ericjhoh/6-DOF-Arm/blog_documentation.docx

# Blog Documentation

## 8/20/2026

Due to all the backlash from the first version of the 30:1 Cycloidal Gearbox, I decided that there were likely 2 things to change that could reduce the given backlash.

1. 3D-print the cycloidal disks slightly larger than before.
2. Reprint the input wall so that the holes holding the roller pins were press-fit instead of loose fit.

I believed that the loose fit of the previous input wall roller pin holes allowed the pins to move slightly when the cycloidal disk applied pressure to the bearings. This means that when switching directions the cycloidal disk would have some give before the disk and the rollers latch back together.

## 8/21/2026

This day was spent printing most of the parts and testing whether they would fit. I found that printing the disk with an offset of .1 mm to increase the size worked the best with my 3d printer. The input wall holes for the roller should be the nominal 5 mm diameter.

## 8/22/2026

After assembly, I observed much less backlash than before and I will be testing the efficiency of the gearbox and compare it to version 1 of the 30:1 cycloidal gearbox. I will also be printing the 15:1 gearbox in the following days after adding identifiers in the CAD to make assembly easier.

## 8/23/2026

I spent this day printing most of the parts. I ran into some issues with the fitting of the shoulder bolts that secure the outer walls of the print, it was very tight for the 15:1.

## 8/24/2026

After assembling the entirety of the 15:1 gearbox, I noticed that the input shaft felt difficult to turn as if it were experiencing a lot of friction. From my observations it seemed like one of the input camshaft part was rubbing against the output flange making more friction.

## 8/25/2026

I didn’t get to work that much on the project this day, but I disassembled the 15:1

## 8/26/2026

After making some edits to the CAD, I am reprinting many parts so that they fit better together.
