ericjhoh/6-DOF-Arm/6-DOF-Arm_Documentation (1).docx

# 6-DOF-Arm Documentation

By Eric Oh

8/13/2026

# Introduction:

The goal of this project is to fully develop a 6 degrees of freedom robotic arm that can accomplish a pick and place task. Possible integration with a future drone to support a landing pad.

# Requirements:

## Functional

- Six independently actuated rotational degrees of freedom.
- Complete a pick-and-place task: approach, grasp, transport, and release a target object.
- Design payload of 0.4 kg at the tool center point (TCP).
- 400 mm reach measured from the base yaw axis to the TCP.
- Capture teleoperated demonstrations and reproduce the task autonomously through imitation learning.
- Stretch goal: serve as a landing-pad manipulator for a future drone platform.

## Mechanical

- Every joint must hold at least a 1.2x torque margin over its worst-case static holding torque.
- Structure must be manufacturable with the fabrication capability actually on hand: a consumer FDM 3D printer, set screws, and heat-set inserts. No epoxy, no machined inserts, no outsourced machining.
- Link mass budget of 0.06 kg per link (carbon fiber tube plus printed clamps).
- Joint gearboxes must couple to one another without introducing an axial offset that creates a large parasitic moment.

## Electrical

- All six actuators share a common power rail and a single CAN-FD bus in a daisy-chain topology.
- Absolute rotary position feedback at every joint.
- Controller mounting must not interfere with motor body geometry or rotor magnet standoff.

## Software

- Run on the LeRobot stack for demonstration recording, policy training, and inference.
- Per-joint commissioning through the moteus tooling (calibration, position/velocity/torque control modes).

# System Architecture:

The arm is built around Architecture v2, which replaced the original stepper-driven concept with quasi-direct-drive brushless actuators. The joint order and link lengths are as follows:

Joint | Function | Notes
J1 | Base yaw | Rotates the entire arm about the vertical axis
J2 | Shoulder pitch | Highest-torque joint; drives L1
J3 | Elbow pitch | Drives L2
J4 | Forearm roll | Located at the elbow, not at the wrist
J5 | Wrist pitch | Wrist assembly
J6 | Tool roll | End effector rotation

Link geometry: L1 = L2 = 160 mm, giving a 400 mm total reach with the wrist and tool stack included. Placing J4 at the elbow rather than the wrist keeps the roll actuator mass closer to the shoulder, which reduces the inertia and holding torque that J2 and J3 have to carry.

# Actuation:

The arm uses two actuator families. The three proximal joints, which carry the bulk of the load, use MJ5208 brushless motors driven by moteus r4.11 controllers through custom cycloidal reducers. The three distal wrist joints use SteadyWin GIM3505-8 integrated gearmotors driven by moteus-c1 controllers.

Joint | Motor | Controller | Reduction | Reducer type
J1 | MJ5208 | moteus r4.11 | 15:1 | Custom cycloidal
J2 | MJ5208 | moteus r4.11 | 30:1 | Custom cycloidal
J3 | MJ5208 | moteus r4.11 | 15:1 | Custom cycloidal
J4 | GIM3505-8 | moteus-c1 | 8:1 | Integrated planetary
J5 | GIM3505-8 | moteus-c1 | 8:1 | Integrated planetary
J6 | GIM3505-8 | moteus-c1 | 8:1 | Integrated planetary

## MJ5208 (J1-J3)

The MJ5208 is a 5208-frame brushless motor sold by mjbots, wound at 330 Kv and intended specifically for pairing with moteus controllers. It is a bare motor, so there are no gearbox and no encoder, which is why J1-J3 need the custom cycloidal reducers and a separately mounted diametric magnet.

Parameter | Value
Frame size | 5208
Peak torque | 1.7 N.m
Peak power | 600 W
Kv | 330 rpm/V
Maximum speed | 7500 RPM

### Derived torque constant

From Kv = 330 rpm/V, the torque constant is approximately 9.55 / 330 = 0.029 N.m/A at the rotor. Producing the rated 1.7 N.m peak therefore requires roughly 59 A of phase current. Kv conventions vary between manufacturers by 10-15 percent depending on how the winding is referenced, so treat this as an estimate until calibration returns a measured value.

### Peak versus continuous output - important

The 1.7 N.m headline figure is a transient peak, not a torque the joint can hold. The moteus r4.11 is rated at 100 A peak phase current but only 12 A continuous uncooled (32 A with thermal management), and the shoulder holding a pose is a continuous demand, not a transient one. Working the numbers through both reduction ratios:

Operating point | Phase current | Motor torque | J2 output (30:1) | J1/J3 output (15:1)
Peak (transient only) | ~59 A | 1.7 N.m | 51 N.m | 25.5 N.m
Continuous, cooled | 32 A | 0.93 N.m | 27.7 N.m | 13.9 N.m
Continuous, uncooled | 12 A | 0.35 N.m | 10.4 N.m | 5.2 N.m

All of these are before cycloidal efficiency losses, 3D-printed part compliance, and any thermal derating of the motor itself, so real sustained output is lower still.

The practical consequence is that the honest number for the J2 static holding case is 10.4 N.m, not 51 N.m - roughly a factor of five smaller. If the torque budget was built against the peak figure, that alone could explain why the shoulder margin looks marginal. Adding a heat spreader or fan to the J1-J3 controllers moves the continuous ceiling from 12 A to 32 A and is the cheapest available lever on this problem.

## GIM3505-8 (J4-J6)

The GIM3505-8 is an integrated 8:1 planetary gearmotor with an onboard 14-bit magnetic encoder. Because the wrist joints see far lower torque than the shoulder and elbow, an off-the-shelf integrated unit is used here rather than a custom reducer, which saves both design time and distal mass.

Manufacturer specifications (from the GDZ-driver planetary reduction motor selection table):

Parameter | Value
Gear ratio | 8:1
Gearbox type | Planetary, aluminum gears
Rated torque (output) | 0.67 N.m
Peak torque (output) | 1.79 N.m
Rated speed (output) | 230 RPM
Maximum speed (output) | 400 RPM
Rated voltage | 24 V
Operating voltage range | 12-40 V
Rated power | 36.72 W
Rated current | 1.53 A
Peak current | 3.99 A
Torque constant | 0.44 N.m/A (output-referenced)
Speed constant | 16.67 rpm/V (output-referenced)
Phase resistance | 5.473 ohm
Phase inductance | 0.476 mH
Gear backlash | 15 arcmin

### Torque headroom at the wrist

The 0.67 N.m continuous rating is generous for this application. A 0.2 kg payload weighs 1.96 N, so it demands roughly 0.20 N.m at J5 for every 100 mm of offset between the J5 axis and the payload center of mass. J5 therefore stays inside its continuous rating out to about 340 mm of offset - far beyond anything the wrist geometry will produce. The wrist joints are not the constraint on this arm; the shoulder is.

### Driver substitution: moteus-c1 in place of the GDZ34

The GIM3505-8 normally ships with a GDZ34 integrated driver. This design discards it in favor of the moteus-c1, so that all six joints run the same firmware, the same CAN-FD bus, and the same torque-control interface. That substitution means the motor has to be characterized at the rotor rather than at the output, since the moteus-c1 commutates the rotor directly:

- Pole pairs: 11 - used directly in the moteus configuration.
- Phase resistance 5.473 ohm, phase inductance 0.476 mH - these set the current-loop bandwidth and gains during calibration.
- Rotor-referenced torque constant: ~0.055 N.m/A (0.44 divided by the 8:1 ratio). The catalog value is measured at the gearbox output, so using 0.44 directly in a rotor-side configuration would overestimate torque by 8x.
- Rotor-referenced speed constant: ~133 rpm/V (16.67 multiplied by 8), for the same reason.

The stock GDZ34 speaks CAN and RS-485; the moteus-c1 speaks CAN-FD. Since the GDZ34 is being removed anyway, this protocol difference does not need to be bridged.

### Integration between GIM3505-8 and moteus-c1

Integrating the GIM3505-8 motor with the moteus-c1 can be done by ordering the GIM3505-8 with an AS5047P encoder. This is the same encoder that is on the moteus-c1 controller. In order to connect the external AS5047P encoder with the moteus-c1, AUX2 must be used on the controller. INSERT DOCUMENTATION

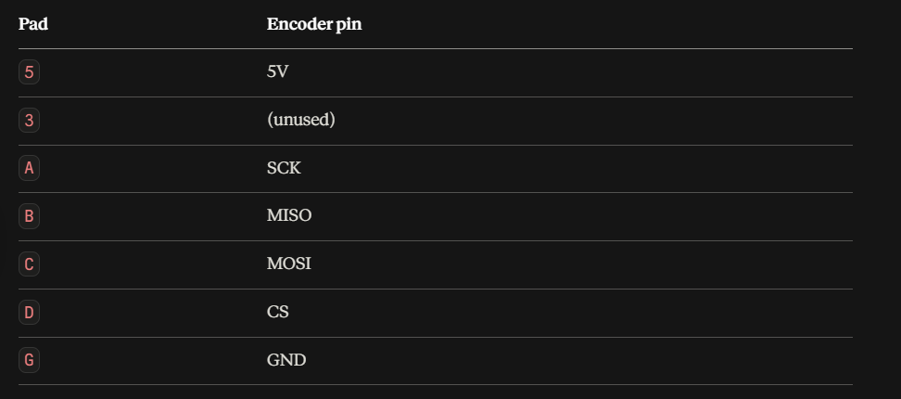
[picture p1: figure]

And the 3 phases can be connected to the 3 phases of the motor. In addition, some configurations must be set through the moteus-c1

conf set aux1.spi.mode 1

conf set aux2.pins.0.mode 1

conf set aux2.pins.1.mode 1

conf set aux2.pins.2.mode 1

conf set aux2.pins.3.mode 2

conf set aux2.spi.mode 2

conf set aux2.spi.rate_hz 12000000

conf set motor_position.sources.0.aux_number 2

conf set motor_position.sources.0.type 1

conf set motor_position.sources.0.cpr 16384

conf set motor_position.sources.0.reference 0

conf set motor_position.commutation_source 0

conf set motor_position.output.source 0

conf set motor_position.rotor_to_output_ratio 0.125

conf write

Three blocks: get the old sensor out of the way, describe the physical hardware, then say what the readings mean.

Freeing the onboard encoder

aux1.spi.mode 1 — sets AUX1's SPI to Disabled. The default is 0, meaning the onboard AS5047P. Without this the firmware keeps polling a chip with no magnet in front of it and reports faults. This is the line that makes the whole plan work, since the c1 has no way to physically remove that sensor.

Describing the hardware on AUX2

aux2.pins.0/1/2.mode 1 — pins A, B, C become the SPI bus (clock, MISO, MOSI, in that fixed order). Three separate lines because each pin is configured independently; the firmware doesn't infer that enabling one implies the others.

aux2.pins.3.mode 2 — pin D becomes chip select, for the reason from the last message: it's a GPIO the firmware toggles, not part of the shared bus.

aux2.spi.mode 2 — declares that an AS5047-family part is on that bus. This selects the register-level protocol: which address to read, how the 14-bit angle is packed, what the parity bit means. The pin modes above build the road; this says what's at the end of it.

aux2.spi.rate_hz 12000000 — bus clock. This is the one line you can drop — it's already the default. I included it as a marker for the value you'll be turning down if error counts appear once the motor is driving.

Saying what the reading means

The first four lines configure "source 0," one of several sensor slots the firmware can track.

sources.0.aux_number 2 — this source lives on AUX2. Necessary because sources and ports are decoupled; nothing so far has connected the two.

sources.0.type 1 — read it as SPI, rather than quadrature or I2C.

sources.0.cpr 16384 — counts per revolution. The AS5047P is 14-bit, so 2^14. This is how raw counts become an angle; wrong here and everything downstream scales wrong.

sources.0.reference 0 — this sensor measures the rotor, not the output. True for your setup: the encoder sits behind the motor, ahead of the planetary. This is a claim about mechanical reality, and the one line most likely to be wrong if you ever move an encoder to the output side.

Wiring the source into the control loop

The 0 in the next two lines is a source index, not an enum value — it means "source 0," the thing just defined.

motor_position.commutation_source 0 — use it to time the phase currents. Requires a rotor-referenced source, which is why reference 0 above matters.

motor_position.output.source 0 — also use it to report position. On a joint with only one sensor, both jobs fall to the same source. They're separate fields because a two-encoder joint would split them.

rotor_to_output_ratio 0.125 — output turns per rotor turn, i.e. your 8:1. Without it, positions and velocities come back in rotor revolutions and every command you write is off by 8×.

conf write — commits to flash. Everything above is RAM-only until this runs.

The short version of why nothing is redundant: the pin lines describe electrical routing, spi.mode describes the protocol, the source lines describe what the number physically represents, and the last three describe what the control loop should do with it. Each layer is independent, so each needs stating.

# Cycloidal Reducer Design:

Two reducer designs were developed: a 30:1 unit for the shoulder and a 15:1 unit built in two copies for the base yaw and elbow. Both share the same architectural pattern - twin cycloidal discs mounted 180 degrees out of phase to cancel the eccentric imbalance, a hex input shaft, ring rollers on pins, and an output roller pin circle.

## 30:1 Reducer (J2 - Shoulder)

Parameter | Value
Reduction ratio | 30:1
Ring diameter | 120 mm
Ring rollers | 31 rollers, 10 mm diameter (5 mm radius)
Camshaft diameter | 20 mm
Output pin circle | 80 mm
Output rollers | 8 rollers, 10 mm diameter
Cycloidal discs | 2 discs, 8 mm thick, 180 degrees apart
Eccentricity | 1.0 mm
Profile coefficient K1 | 0.52
Input | Hex shaft
Disc material | PLA or PETG (selection pending)
Assembly mass | ~1.32 kg including motor and controller

The cam assembly requires two eccentric bearings (one per disc) plus two support bearings in line with the input axis, so the eccentric loads are reacted on both sides rather than cantilevered. INSERT DOCUMENTATION OF TESTING AND RESULTS AND DESIGN ITERATION

Status note: at 120 mm ring diameter and 1.32 kg assembled, this unit is judged too large for the shoulder. Shrinking the envelope is an active work item; the constraint is that any reduction in ring diameter reduces the moment arm at the output rollers and therefore the torque capacity, so the shrink cannot be a straight scale-down.

## 15:1 Reducer (J1 - Base Yaw, J3 - Elbow)

Two identical units are being built from a common template.

Parameter | Value
Reduction ratio | 15:1
Ring rollers | 16 rollers, 10 mm diameter (5 mm radius)
Camshaft diameter | 10 mm
Output rollers | 6 rollers, 10 mm diameter
Cycloidal discs | 2 discs, 180 degrees apart
Disc center hole | ~20 mm
Output roller holes | ~12 mm
Input | 5 mm hex shaft
Cam | 3D printed

# Electronics and Control:

## Bus topology

All controllers sit on a shared power rail and a single CAN-FD daisy chain. Three moteus r4.11 controllers are currently in hand and are being wired into this chain for J1-J3; the three moteus-c1 controllers for the wrist join the same bus.

Parameter | moteus r4.11 (J1-J3) | moteus-c1 (J4-J6)
Voltage input | 10-44 V | 10-51 V
Peak phase current | 100 A | 20 A
Continuous phase current (uncooled) | 12 A | 5 A
Continuous phase current (cooled) | 32 A | 14 A
Peak electrical power | 900 W @ 30 V | 250 W @ 28 V
Mass | 14.2 g | 8.9 g
Dimensions | 46 x 53 mm | 38 x 38 x 9 mm
CPU | STM32G4 | STM32G4
Communications | 5 Mbps CAN-FD | 5 Mbps CAN-FD

Both boards run the same firmware image and use the same power, CAN, and AUX2 connectors, so the mixed r4.11 / c1 chain behaves as one homogeneous bus from the host's point of view.

Rail voltage is set at 24 V. The binding constraint is the GIM3505-8's 12-40 V operating window - narrower than either controller's input range - and 24 V is also the GIM3505-8's rated voltage. This sits comfortably inside the r4.11's 10-44 V and the c1's 10-51 V.

Current headroom check: the GIM3505-8 draws 1.53 A rated and 3.99 A peak, against the c1's 5 A continuous and 20 A peak. The wrist is comfortably matched. The MJ5208 side is the opposite case - the motor can absorb far more current than the r4.11 can continuously supply, so the controller, not the motor, sets the sustained torque ceiling at J1-J3.

## Position feedback

- J1-J3: moteus-style on-axis magnetic encoder, using a diametric magnet mounted on the stator-side axle. This is the standard moteus rotor-position arrangement and keeps the sensing on the motor side of the reducer.
- J4-J6: the plan is to wire the GIM3505-8's own motor-side AS5047P to the moteus-c1, rather than using the AS5047P that is already onboard the c1. This sidesteps the magnet standoff problem described below, since the motor's factory encoder is already correctly spaced from its own rotor magnet.

## Bring-up status

Currently at hardware bring-up: running moteus_tool --calibrate against an MJ5208 + moteus r4.11 pair on Windows under miniconda. Calibration establishes the commutation offset and encoder mapping, and has to be completed per motor-controller pair before any closed-loop position control.

# Software and Learning Stack:

The arm targets imitation learning as its control approach rather than classical trajectory planning. The intended pipeline is:

1. Record teleoperated demonstrations of the pick-and-place task.
2. Train a policy on those demonstrations using the LeRobot stack.
3. Run inference on the trained policy with the arm executing autonomously.

This choice drives several hardware requirements upstream: joints need smooth, backdrivable-feeling torque control for teleoperation, and the control loop needs consistent timing, which is why every joint runs a moteus controller with onboard closed-loop control rather than a step/direction driver.

# Design History:

## v1 - Stepper architecture (superseded)

The original design used NEMA 17 stepper motors with TMC2209 drivers. Two problems ended this approach:

- Torque margin. Steppers at this frame size could not deliver the holding torque required at the shoulder within the 1.2x margin, even before accounting for reducer losses.
- Driver current mismatch. The TMC2209 could not supply the 2.0 A/phase the selected motors required. The options were to upgrade to TMC5160 drivers or to drop to lower-current motors; the latter would have made the torque problem worse.

Rather than upgrade the drivers, the architecture moved to quasi-direct-drive brushless motors with moteus controllers, which solves the torque margin, the current capability, and the torque-control requirement for imitation learning in one change.

## v2 - Brushless architecture (current)

MJ5208 + moteus r4.11 with custom cycloidal reducers on J1-J3; GIM3505-8 + moteus-c1 on J4-J6. This is the architecture documented above.

# Open Issues:

## 1. J2 shoulder torque margin below threshold

The shoulder joint's torque margin currently sits below the 1.2x requirement in the torque budget. This is the single most important blocking item, since it determines whether the 30:1 reducer and MJ5208 combination is sufficient at all.

Check the basis of the number first. As set out in the Actuation section, the MJ5208's 1.7 N.m rating is a transient peak requiring roughly 59 A of phase current. Sustained holding torque at J2 is bounded by the moteus r4.11's continuous current rating, which puts the real figure near 10.4 N.m uncooled rather than 51 N.m. If the budget was populated from the peak number, the margin calculation needs redoing before any mechanical change is made in response to it.

Once the basis is confirmed, resolution paths include adding thermal management to the J2 controller (12 A to 32 A continuous, a 2.7x gain for the price of a heat spreader), reducing distal mass, shortening L1, increasing the reduction ratio, or revising the payload target.

## 2. Gearbox-to-gearbox coupling

There is no settled answer for how to connect adjacent joint gearboxes without introducing an axial offset between their output and input planes. Any offset creates a moment arm that loads the reducer output bearings in a direction they are not designed to carry, and the 3D-printed housings are the least tolerant part of the stack to that kind of loading.

## 3. moteus-c1 mounting on the GIM3505-8

- Magnet standoff: the c1 cannot sit close enough to the GIM3505-8's rotor magnet, because the motor's rear geometry interferes with components on the board. The current workaround is to use the motor's own AS5047P instead of the c1's onboard encoder.
- Screw holes: the c1's mounting holes land directly on the motor body. Fastening through them as-is would drive screws into the motor. A standoff or adapter plate is needed.

## 4. 30:1 reducer envelope

The 120 mm ring diameter and 1.32 kg assembly mass are both larger than the shoulder joint can reasonably carry. Shrinking the design without losing torque capacity is unresolved.

## 5. Disc material selection

PLA versus PETG for the cycloidal discs is still open. PLA is stiffer and more dimensionally accurate off the printer, which matters for a profile this sensitive to tolerance; PETG is tougher and less prone to brittle failure under shock loading.

## 6. Wrist backlash is unsensed

The GIM3505-8 has 15 arcmin (0.25 degrees) of gear backlash, and the selection table confirms this model does not support a secondary encoder on the output shaft. Combined with the plan to feed the motor-side AS5047P to the moteus-c1, this means every encoder in the wrist sits on the rotor side of the gearbox and the controller has no way to observe the backlash at all.

Projected to the tool, 15 arcmin is about 0.44 mm of play for every 100 mm of offset from the joint axis, and J4, J5, and J6 stack in series. Two consequences:

- Positioning: the tool has a dead band the controller cannot close, which sets a floor on repeatability for the pick-and-place task.
- Learning: for imitation learning this is worse than a plain accuracy limit. Recorded joint angles will not correspond exactly to the tool pose that actually occurred during the demonstration, so backlash injects label noise into the training data rather than just tracking error at run time.

Options are to accept the dead band and design the gripper to be tolerant of it, add an external output-side encoder independent of the motor, or select a wrist joint that supports secondary output-shaft encoding. Several other models in the same family do support it, though at greater mass.

# Fabrication Constraints:

Everything in this design has to be buildable with what is actually available, which is a meaningful constraint on the mechanical design rather than an afterthought:

- 3D printer - all structural housings, cycloidal discs, cams, and clamps.
- Set screws - shaft and hub retention.
- Heat-set inserts - all threaded interfaces in printed parts (15 M5 inserts per 15:1 reducer).

Not available: epoxy bonding, machined inserts, or any subtractive machining. Every load path therefore has to terminate either in a bearing, a heat-set insert, or a printed feature - which is the main reason the reducers use pins and rollers rather than pressed-in or bonded assemblies.

# Supporting Documents:

Detailed numbers live in the project workbook, 6-DOF-Arm.xlsx, which contains:

- Torque Budget - per-joint worst-case holding torque, available torque, and resulting margin against the 1.2x threshold.
- Timeline - project schedule and milestones.
- BOM - full parts list with quantities and sourcing.

# Next Steps:

1. Complete moteus_tool --calibrate on all three MJ5208 + r4.11 pairs and record the measured resistance, inductance, Kv, and pole count.
2. Resolve the moteus-c1 mounting interference on the GIM3505-8 (standoff/adapter design).
3. Re-derive the J2 torque budget against continuous current limits rather than peak torque, then close the remaining margin gap.
4. Finalize PLA vs PETG and print a full 15:1 reducer for assembly and backlash measurement.
5. Design the inter-gearbox coupling to eliminate the axial offset moment.
6. Revise the 30:1 reducer to a smaller envelope.
7. Bring up the full CAN-FD chain with all six controllers addressed.
8. Build the teleoperation interface and begin recording demonstrations.
