ericjhoh/6-DOF-Arm/CAD/6-DOF Arm/Actuators+Linkages/j4j5_assem/j4j5_assem.SLDASM

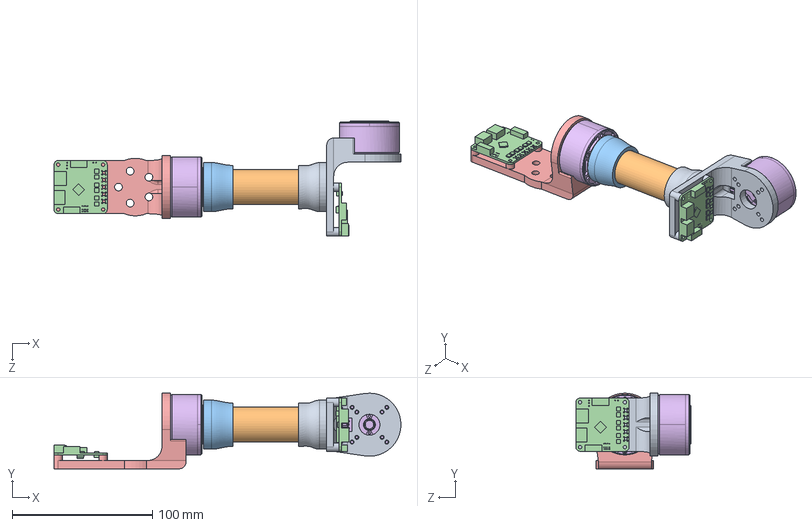
[picture p2: CAD file, 2026-08-28]
CAD/6-DOF Arm/Actuators+Linkages/j4j5_assem/j4j5_assem.SLDASM
247.5 x 54.0 x 82.2 mm
GIM3505-8-3D-Model x 2
j4_connector
moteus_c1 x 2
j5_connector_1
carbon_fiber_tube
j5_connector_2
