ericjhoh/6-DOF-Arm/CAD/GearBoxes/15-1 Cycloidal Gearbox/Gearbox/15-gearbox_ASY.SLDASM

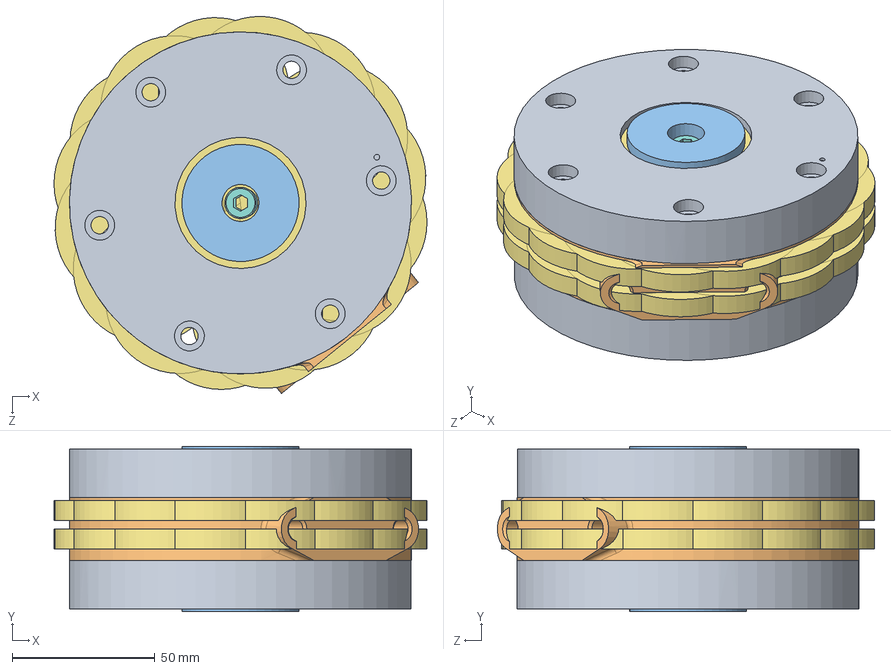
[picture p3: CAD file, 2026-08-28]
CAD/GearBoxes/15-1 Cycloidal Gearbox/Gearbox/15-gearbox_ASY.SLDASM
130.8 x 58.0 x 132.3 mm
15-camshaft_part x 4
bearings x 50
spacers x 69
ring_pin x 22
15-cycloidal_disk_ethan_printing
15-output_flange x 2
15-middle_wall
15-output_wall x 2
