ericjhoh/6-DOF-Arm/CAD/GearBoxes/15-1 Cycloidal Gearbox/Gearbox/Attachments/15-attachment_ASY.SLDASM

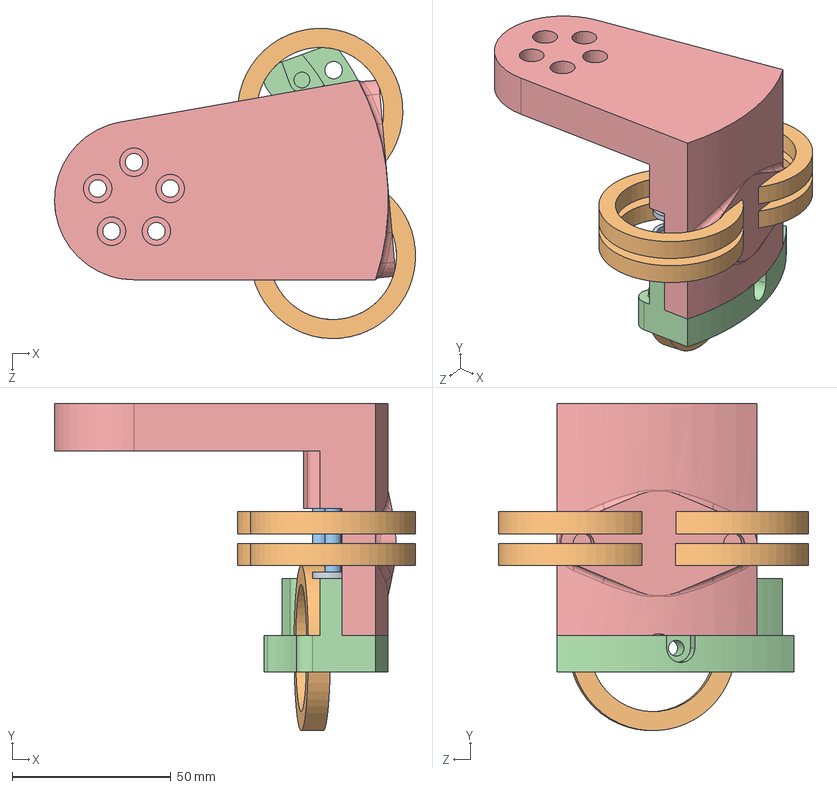
[picture p4: CAD file, 2026-08-11]
CAD/GearBoxes/15-1 Cycloidal Gearbox/Gearbox/Attachments/15-attachment_ASY.SLDASM
113.6 x 102.9 x 97.6 mm
15-attachment1
15_attachement2
ring_pin x 2
bearings x 5
spacers x 6
