ericjhoh/6-DOF-Arm/CAD/GearBoxes/30-1 Cycloidal Gearbox/Gearbox/30-disk+output_ASY.SLDASM

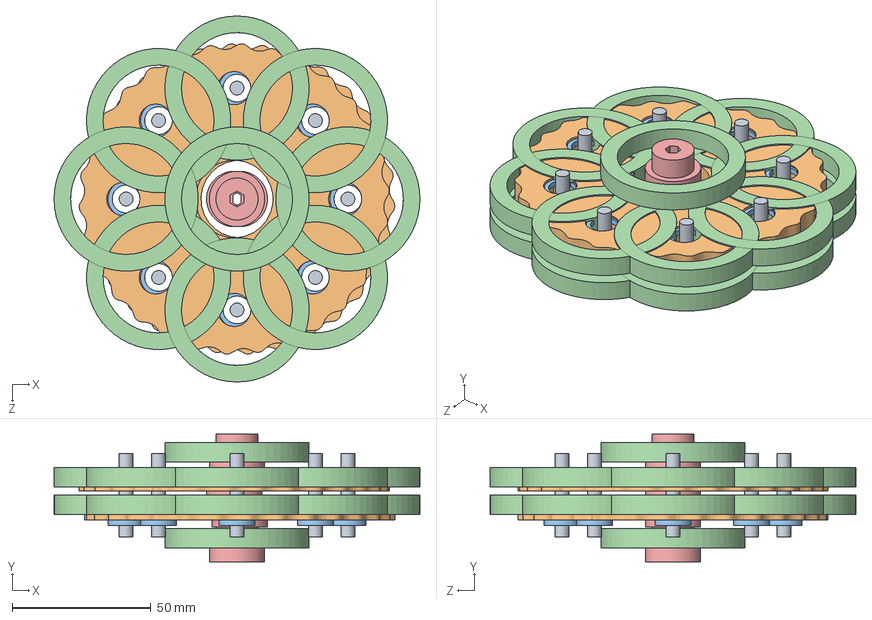
[picture p5: CAD file, 2026-08-27]
CAD/GearBoxes/30-1 Cycloidal Gearbox/Gearbox/30-disk+output_ASY.SLDASM
132.0 x 46.0 x 132.0 mm
30-camshaft_part x 4
bearings x 20
spacers x 27
30-cycloidal_disk x 2
ring_pin x 8
