ericjhoh/6-DOF-Arm/CAD/GearBoxes/Motor Housing/8_1 gearbox housings/Gim_motor+housing_ASY.SLDASM

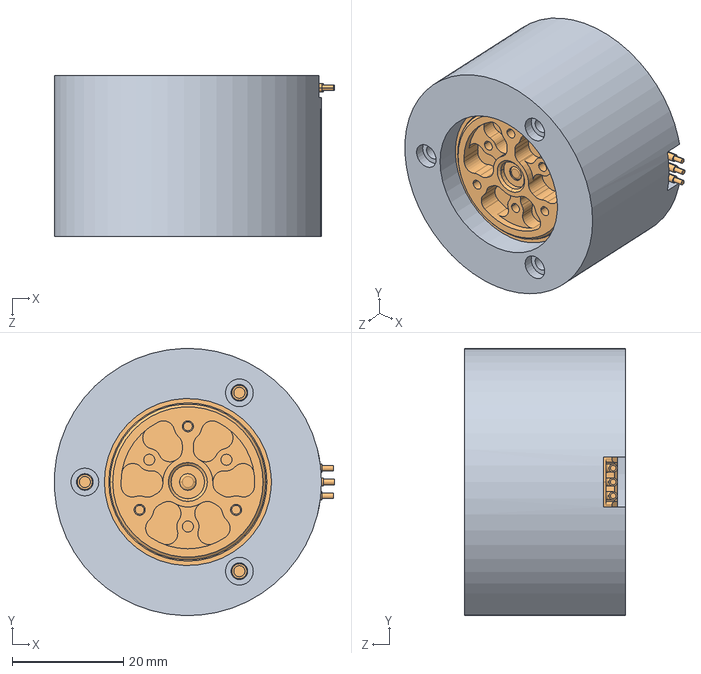
[picture p6: CAD file, 2026-08-12]
CAD/GearBoxes/Motor Housing/8_1 gearbox housings/Gim_motor+housing_ASY.SLDASM
50.3 x 48.0 x 29.0 mm
GIM3505-8-3D-Model
motor housing GIM
