ericjhoh/6-DOF-Arm/CAD/GearBoxes/15-1 Cycloidal Gearbox/Gearbox/15-camshaft_ASY.SLDASM

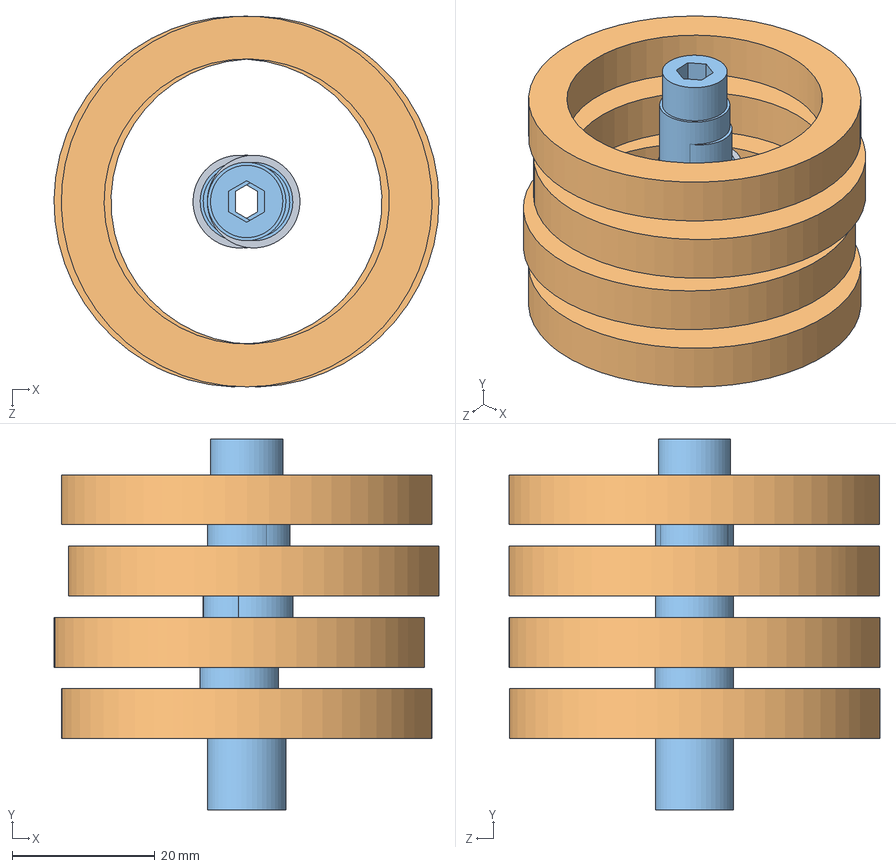
[picture p7: CAD file, 2026-08-28]
CAD/GearBoxes/15-1 Cycloidal Gearbox/Gearbox/15-camshaft_ASY.SLDASM
54.0 x 52.0 x 52.0 mm
15-camshaft_part x 4
bearings x 4
spacers x 3
