ericjhoh/6-DOF-Arm/CAD/GearBoxes/30-1 Cycloidal Gearbox/Gearbox/30-disk+output+rollers_ASY.SLDASM

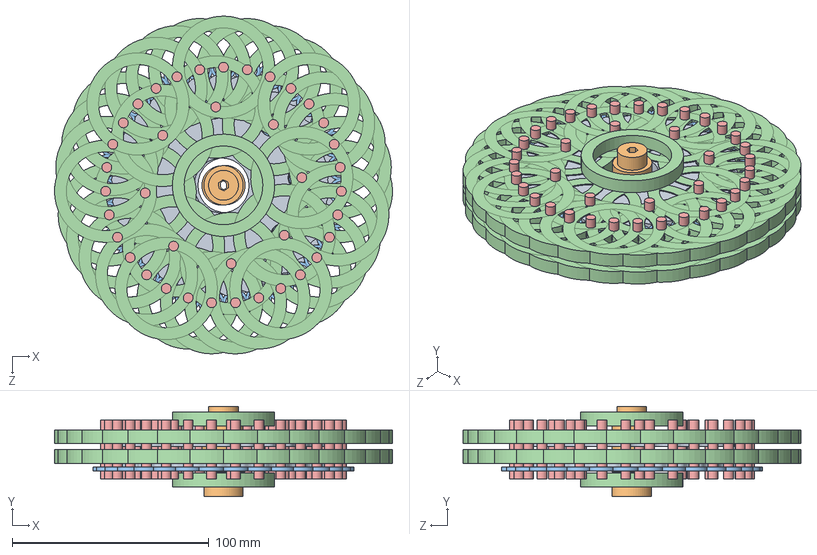
[picture p8: CAD file, 2026-08-27]
CAD/GearBoxes/30-1 Cycloidal Gearbox/Gearbox/30-disk+output+rollers_ASY.SLDASM
171.8 x 46.0 x 171.7 mm
ring_pin x 39
bearings x 82
spacers x 120
30-camshaft_part x 4
30-cycloidal_disk x 2
