ericjhoh/6-DOF-Arm/CAD/GearBoxes/Shared_Parts/roller_pin_ASY.SLDASM

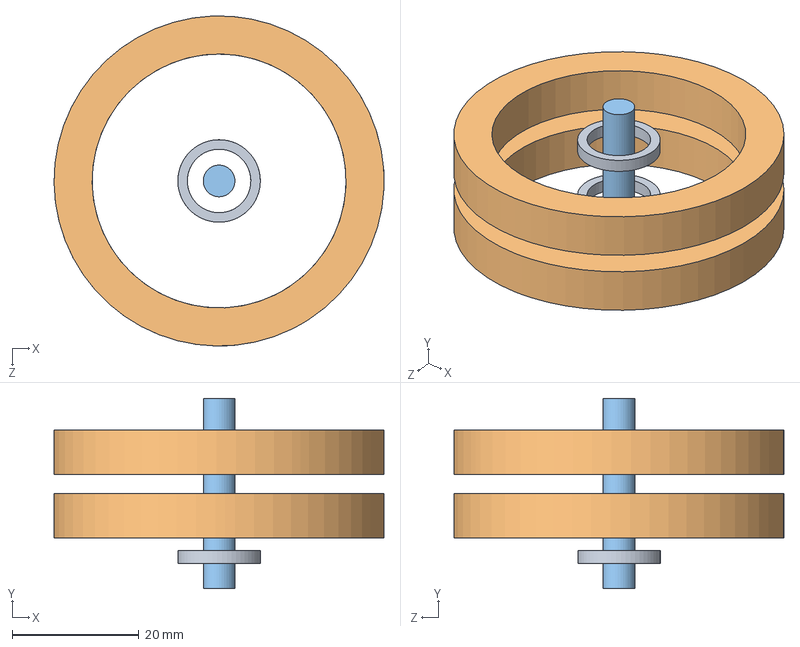
[picture p9: CAD file, 2026-08-11]
CAD/GearBoxes/Shared_Parts/roller_pin_ASY.SLDASM
52.0 x 30.0 x 52.0 mm
ring_pin
bearings x 2
spacers x 3
