ericjhoh/6-DOF-Arm/CAD/GearBoxes/30-1 Cycloidal Gearbox/Gearbox/30-camshaft_ASY.SLDASM

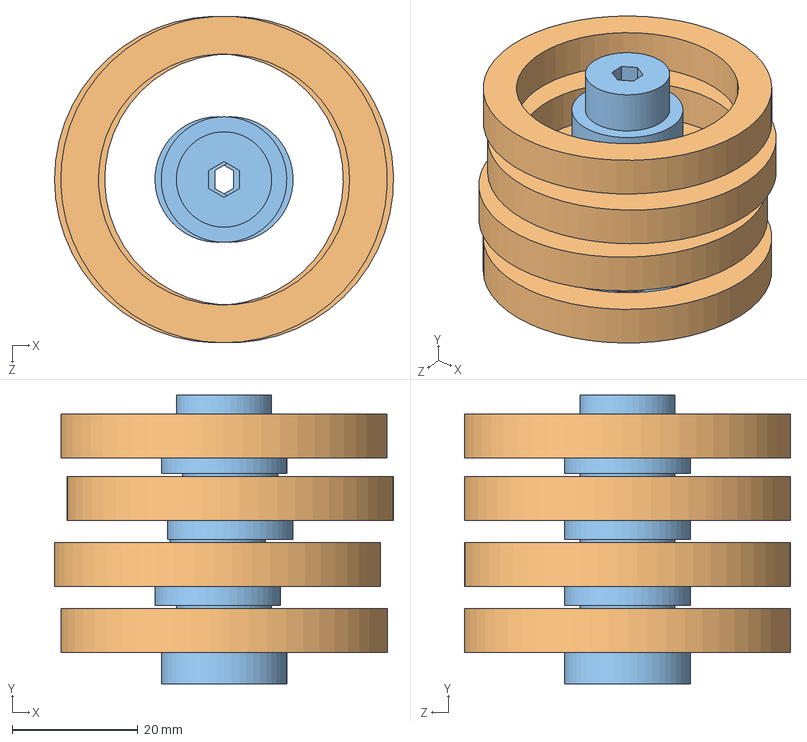
[picture p10: CAD file, 2026-08-26]
CAD/GearBoxes/30-1 Cycloidal Gearbox/Gearbox/30-camshaft_ASY.SLDASM
54.0 x 46.0 x 52.0 mm
30-camshaft_part x 4
bearings x 4
spacers x 3
