ericjhoh/6-DOF-Arm/CAD/GearBoxes/30-1 Cycloidal Gearbox/Gearbox/Attachments/30-attachment_ASY.SLDASM

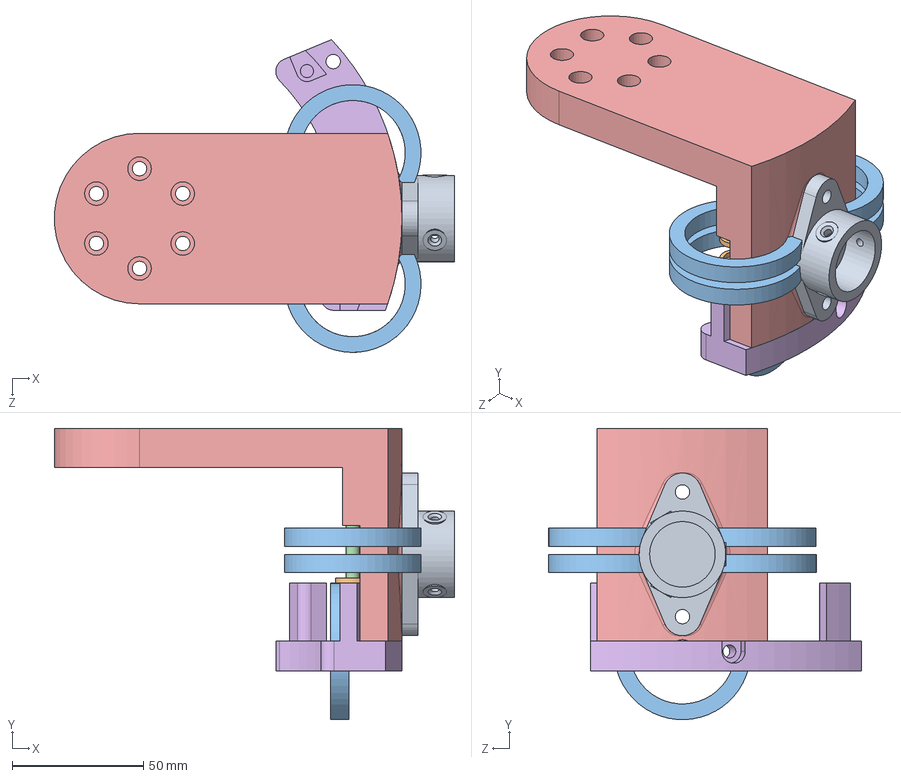
[picture p11: CAD file, 2026-08-26]
CAD/GearBoxes/30-1 Cycloidal Gearbox/Gearbox/Attachments/30-attachment_ASY.SLDASM
152.4 x 111.0 x 119.2 mm
30_attachement2
30-attachment1
ring_pin x 2
bearings x 5
spacers x 6
tube_connector
