ericjhoh/6-DOF-Arm/CAD/GearBoxes/15-1 Cycloidal Gearbox/Gearbox/15-disk+output_ASY_ethan.SLDASM

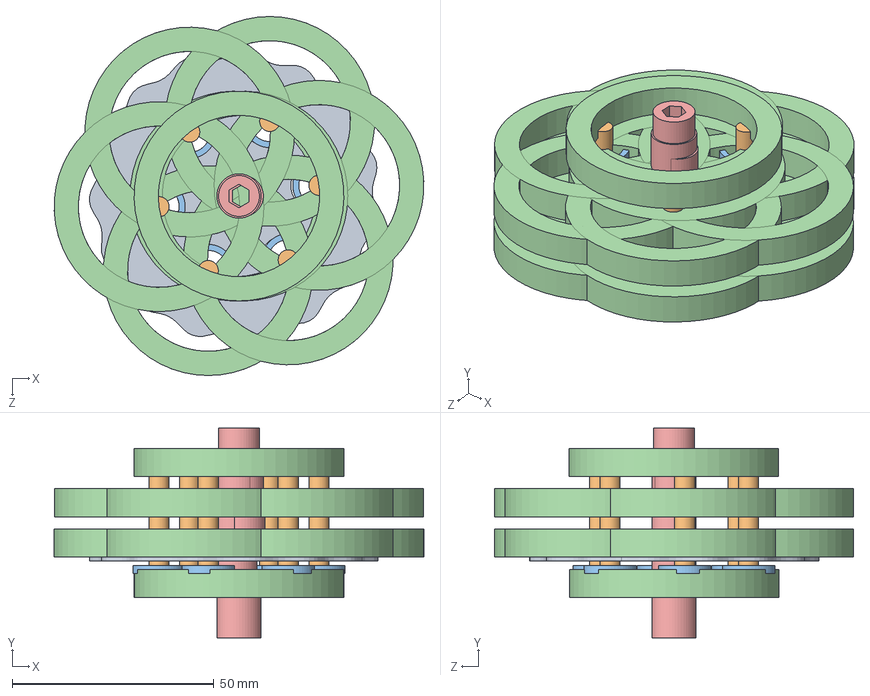
[picture p13: CAD file, 2026-08-28]
CAD/GearBoxes/15-1 Cycloidal Gearbox/Gearbox/15-disk+output_ASY_ethan.SLDASM
91.6 x 52.0 x 89.0 mm
15-camshaft_part x 4
bearings x 16
spacers x 21
ring_pin x 6
15-cycloidal_disk_ethan_printing
