ericjhoh/6-DOF-Arm/CAD/GearBoxes/15-1 Cycloidal Gearbox/Gearbox/15-disk+output+rollers_ASY.SLDASM

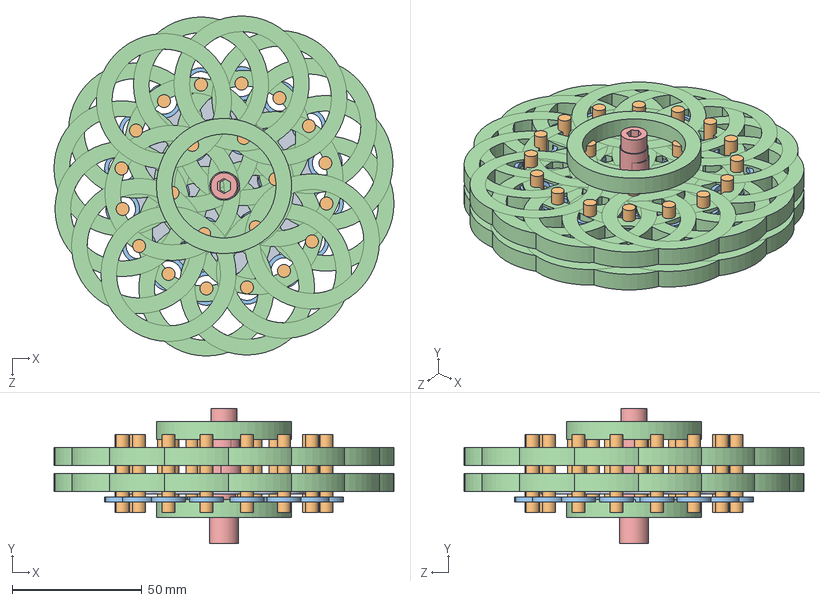
[picture p14: CAD file, 2026-08-28]
CAD/GearBoxes/15-1 Cycloidal Gearbox/Gearbox/15-disk+output+rollers_ASY.SLDASM
130.8 x 52.0 x 130.8 mm
15-camshaft_part x 4
bearings x 48
spacers x 69
ring_pin x 22
15-cycloidal_disk_ethan_printing
