ericjhoh/6-DOF-Arm/CAD/GearBoxes/15-1 Cycloidal Gearbox/Gearbox/Stls/15-stand.STL

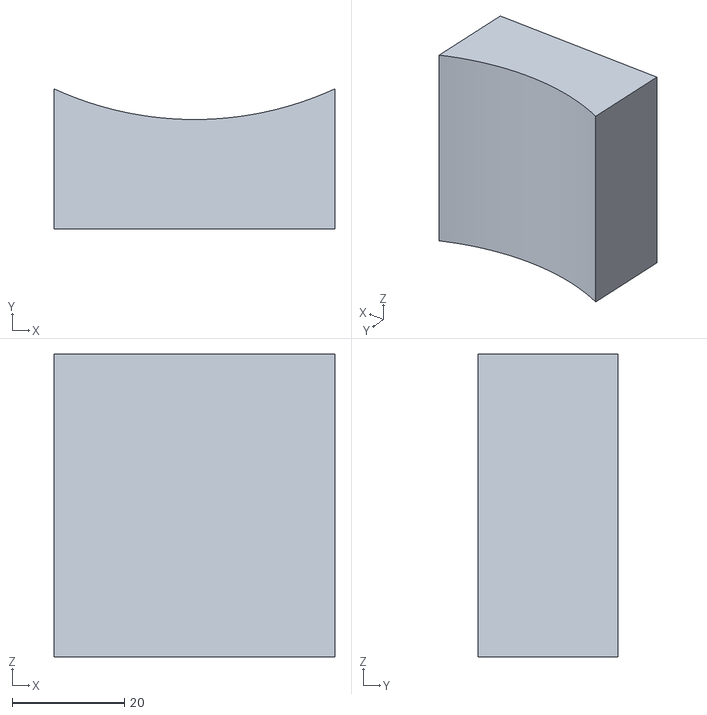
[picture p16: CAD file, 2026-08-28]
CAD/GearBoxes/15-1 Cycloidal Gearbox/Gearbox/Stls/15-stand.STL
50.0 x 25.0 x 54.0
