ericjhoh/6-DOF-Arm/CAD/GearBoxes/30-1 Cycloidal Gearbox/Gearbox/Attachments/30_attachement2.SLDPRT

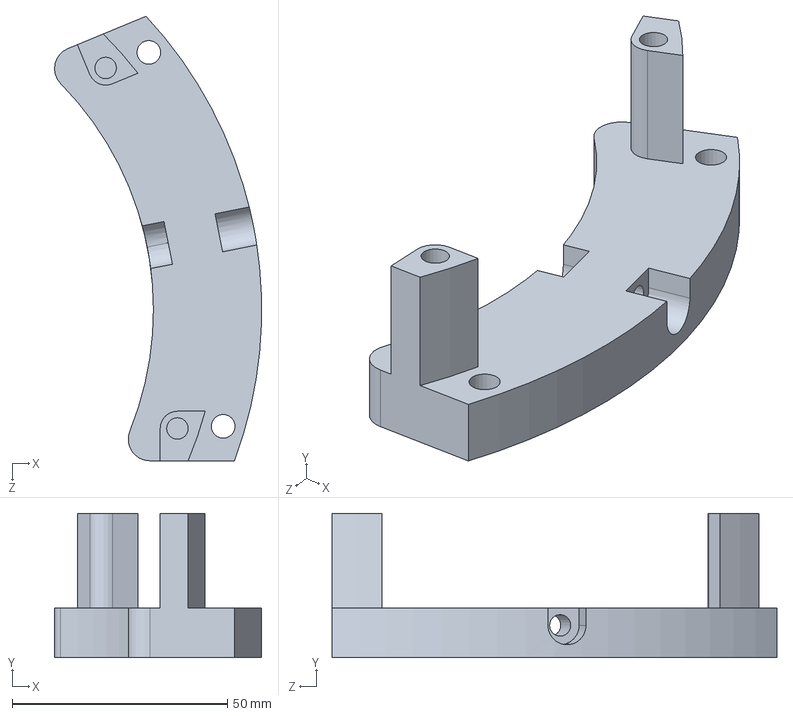
[picture p17: CAD file, 2026-08-26]
CAD/GearBoxes/30-1 Cycloidal Gearbox/Gearbox/Attachments/30_attachement2.SLDPRT
48.0 x 33.5 x 103.2 mm
