ericjhoh/6-DOF-Arm/CAD/GearBoxes/30-1 Cycloidal Gearbox/Gearbox/misc/30-tube_attachment.SLDPRT

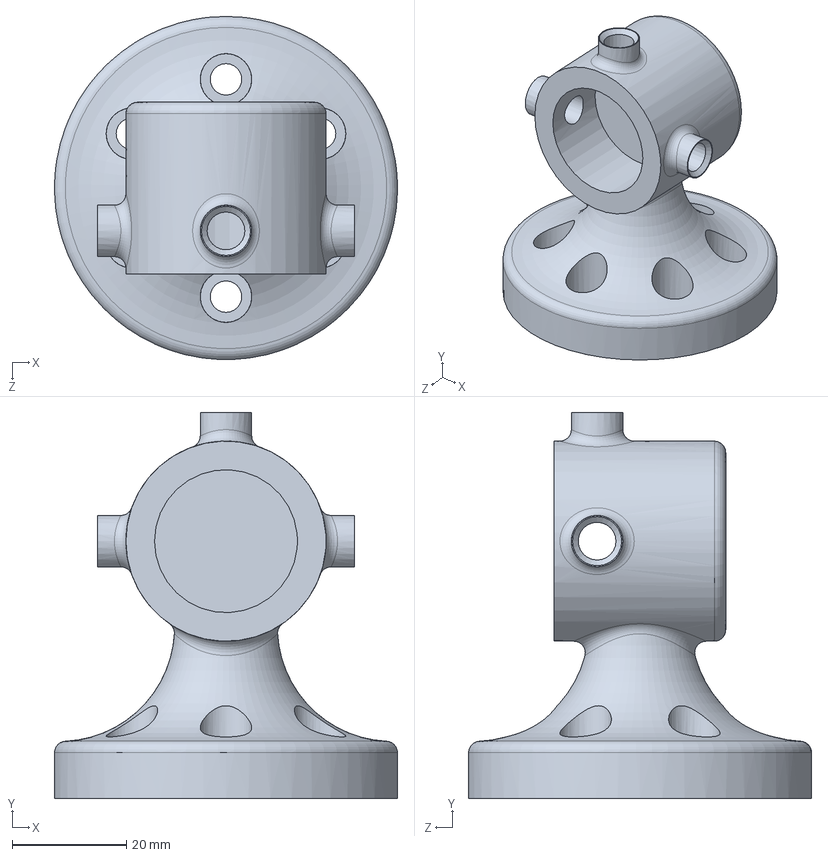
[picture p18: CAD file, 2026-08-06]
CAD/GearBoxes/30-1 Cycloidal Gearbox/Gearbox/misc/30-tube_attachment.SLDPRT
60.0 x 67.5 x 60.0 mm
