ericjhoh/6-DOF-Arm/CAD/GearBoxes/30-1 Cycloidal Gearbox/Gearbox/Stls/30-cycloidal_disk-printing+.5mm.STL

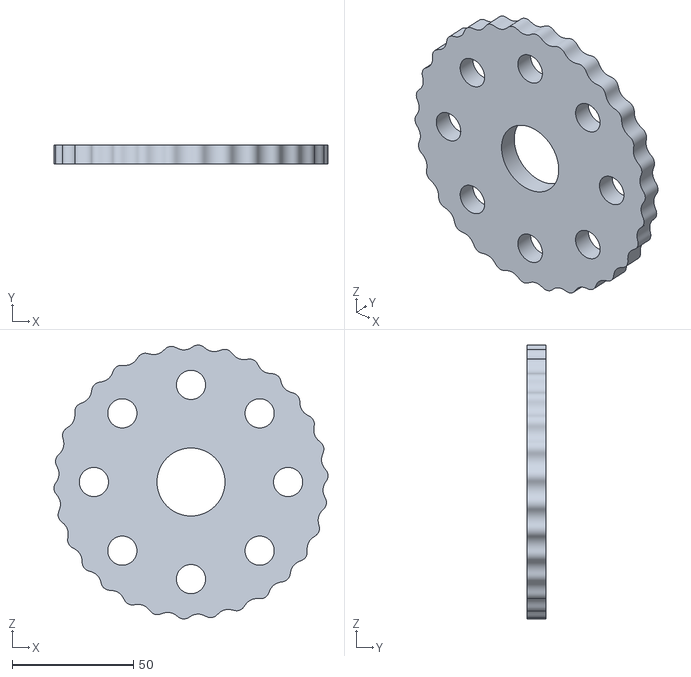
[picture p19: CAD file, 2026-08-26]
CAD/GearBoxes/30-1 Cycloidal Gearbox/Gearbox/Stls/30-cycloidal_disk-printing+.5mm.STL
112.9 x 8.00 x 112.8
