ericjhoh/6-DOF-Arm/CAD/GearBoxes/30-1 Cycloidal Gearbox/Gearbox/Testing/30-lever.SLDPRT

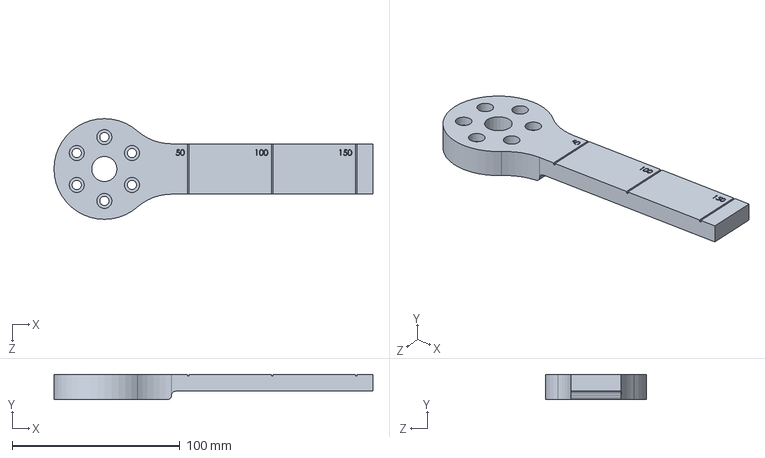
[picture p20: CAD file, 2026-08-26]
CAD/GearBoxes/30-1 Cycloidal Gearbox/Gearbox/Testing/30-lever.SLDPRT
190.0 x 15.0 x 60.0 mm
