ericjhoh/6-DOF-Arm/CAD/GearBoxes/Motor Housing/motor housing.SLDPRT

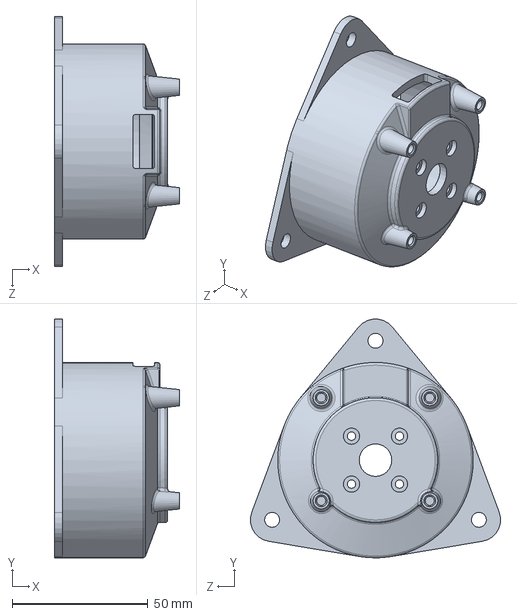
[picture p21: CAD file, 2026-08-28]
CAD/GearBoxes/Motor Housing/motor housing.SLDPRT
46.2 x 87.9 x 92.1 mm
