ericjhoh/6-DOF-Arm/CAD/GearBoxes/Shared_Parts/spacers.SLDPRT

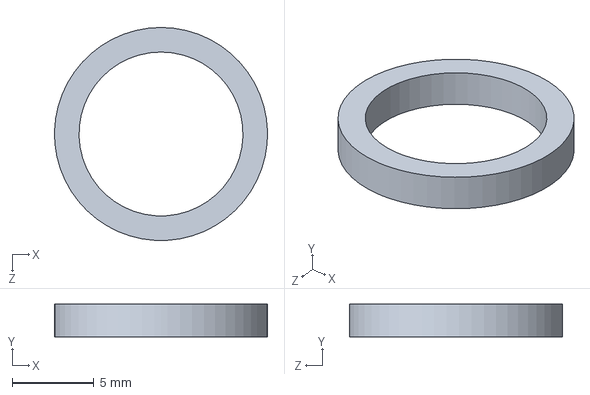
[picture p22: CAD file, 2026-08-26]
CAD/GearBoxes/Shared_Parts/spacers.SLDPRT
13.0 x 2.00 x 13.0 mm
