ericjhoh/6-DOF-Arm/CAD/GearBoxes/test printing/testing tolerances.SLDPRT

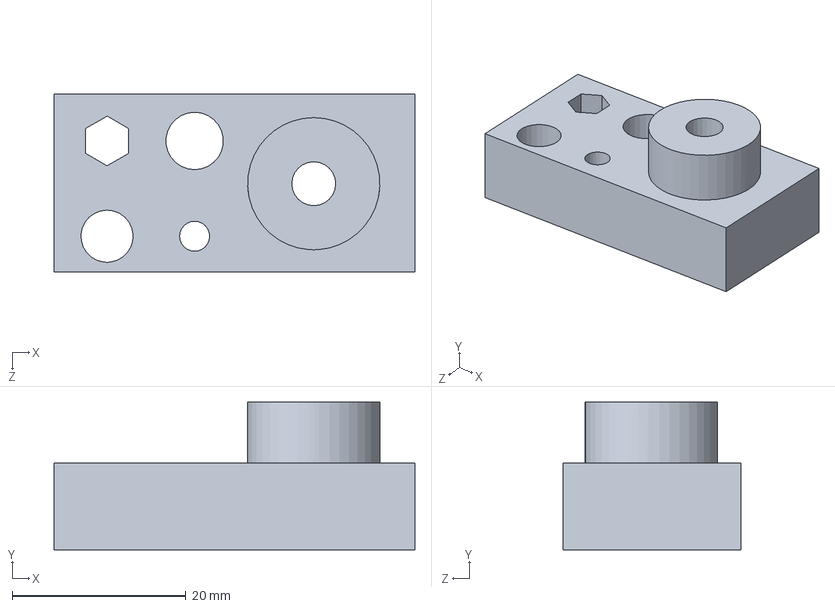
[picture p23: CAD file, 2026-07-30]
CAD/GearBoxes/test printing/testing tolerances.SLDPRT
41.5 x 17.0 x 20.5 mm
