ericjhoh/6-DOF-Arm/CAD/6-DOF Arm/Actuators+Linkages/j4j5_assem/carbon_fiber_tube.SLDPRT

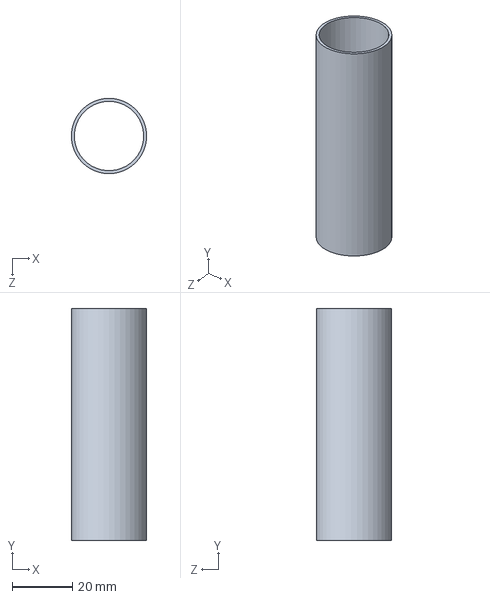
[picture p24: CAD file, 2026-08-27]
CAD/6-DOF Arm/Actuators+Linkages/j4j5_assem/carbon_fiber_tube.SLDPRT
24.9 x 77.0 x 25.0 mm
