ericjhoh/6-DOF-Arm/CAD/GearBoxes/15-1 Cycloidal Gearbox/Gearbox/Attachments/15-attachment1.SLDPRT

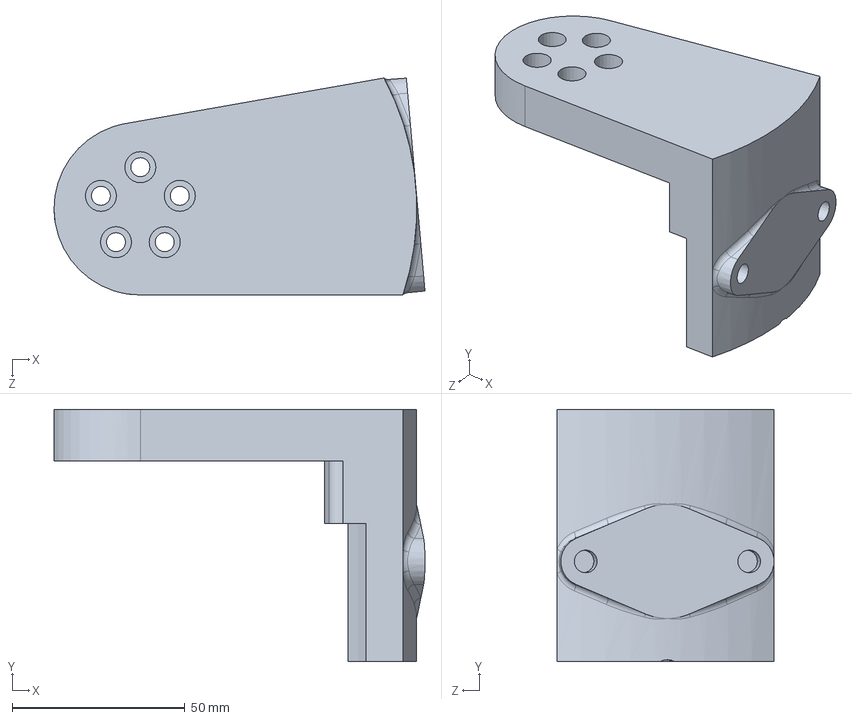
[picture p25: CAD file, 2026-08-11]
CAD/GearBoxes/15-1 Cycloidal Gearbox/Gearbox/Attachments/15-attachment1.SLDPRT
107.4 x 73.0 x 62.8 mm
