ericjhoh/6-DOF-Arm/CAD/GearBoxes/15-1 Cycloidal Gearbox/Gearbox/Stls/15-lever.STL

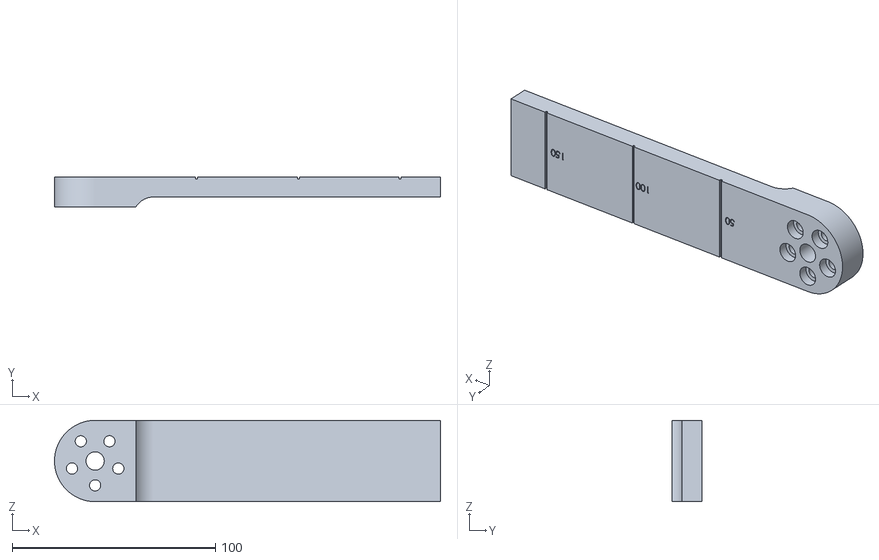
[picture p26: CAD file, 2026-08-28]
CAD/GearBoxes/15-1 Cycloidal Gearbox/Gearbox/Stls/15-lever.STL
190.0 x 15.0 x 40.0
