ericjhoh/6-DOF-Arm/CAD/GearBoxes/30-1 Cycloidal Gearbox/Gearbox/Attachments/30-attachment1.SLDPRT

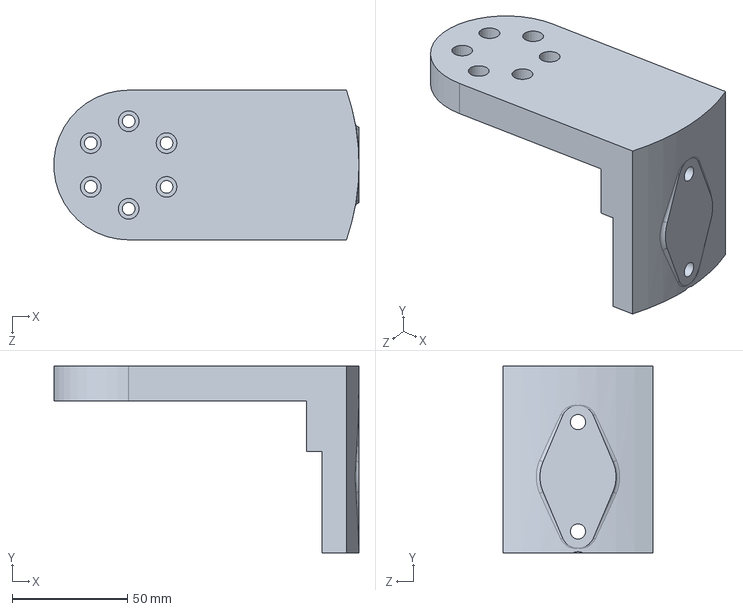
[picture p27: CAD file, 2026-08-26]
CAD/GearBoxes/30-1 Cycloidal Gearbox/Gearbox/Attachments/30-attachment1.SLDPRT
132.4 x 81.0 x 65.0 mm
