ericjhoh/6-DOF-Arm/CAD/GearBoxes/30-1 Cycloidal Gearbox/Gearbox/Testing/30-press.SLDPRT

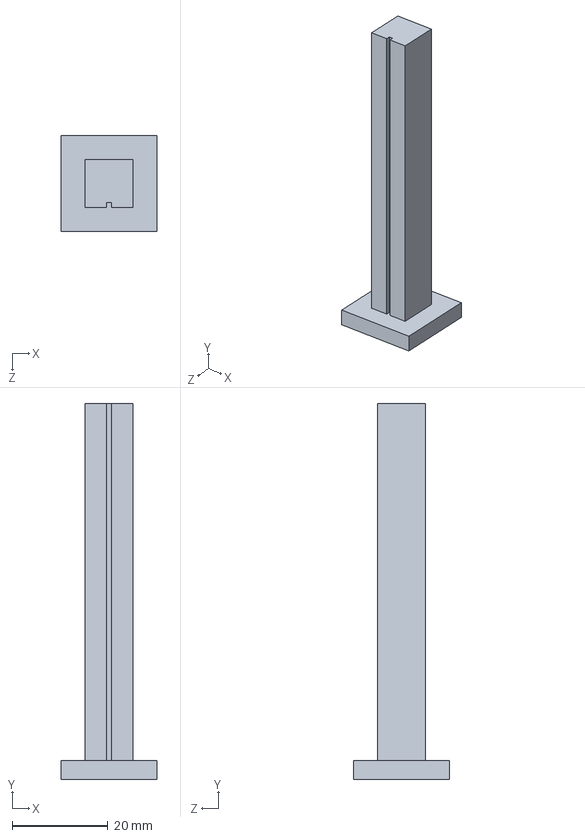
[picture p28: CAD file, 2026-08-03]
CAD/GearBoxes/30-1 Cycloidal Gearbox/Gearbox/Testing/30-press.SLDPRT
20.0 x 78.7 x 20.0 mm
