ericjhoh/6-DOF-Arm/CAD/GearBoxes/Motor Housing/8_1 gearbox housings/motor housing GIM.SLDPRT

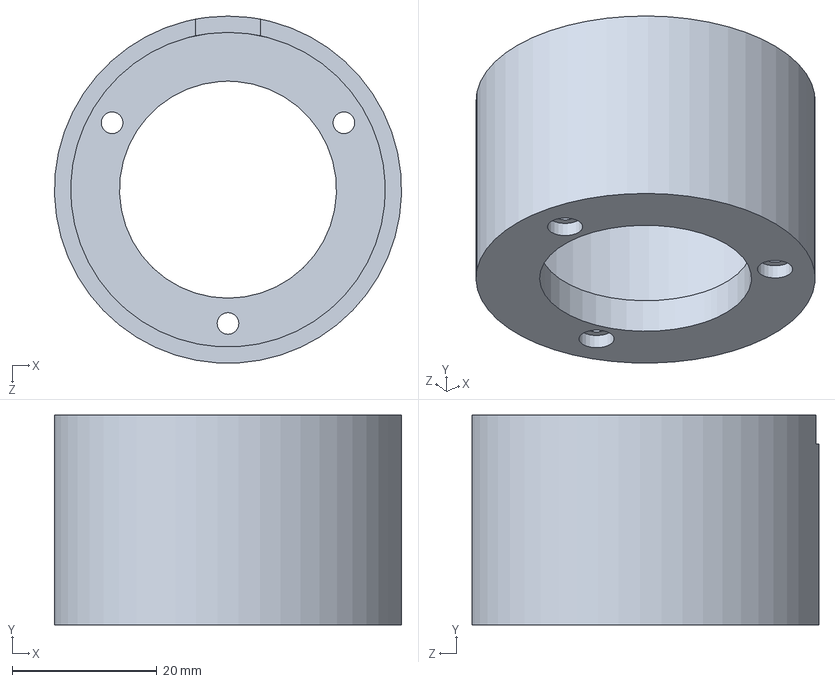
[picture p29: CAD file, 2026-08-12]
CAD/GearBoxes/Motor Housing/8_1 gearbox housings/motor housing GIM.SLDPRT
48.0 x 29.0 x 48.0 mm
