ericjhoh/6-DOF-Arm/CAD/GearBoxes/Motor Housing/GIM3505-8-3D-Model.SLDPRT

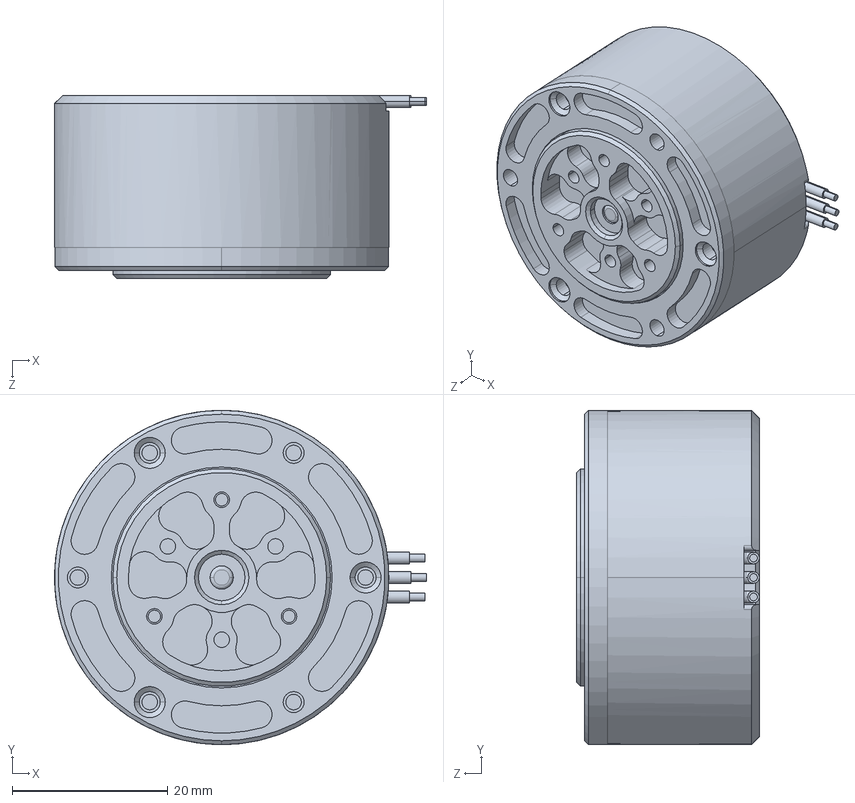
[picture p30: CAD file, 2026-08-11]
CAD/GearBoxes/Motor Housing/GIM3505-8-3D-Model.SLDPRT
47.8 x 43.0 x 23.5 mm
