ericjhoh/6-DOF-Arm/CAD/6-DOF Arm/Actuators+Linkages/j4j5_assem/j5_connector_2.SLDPRT

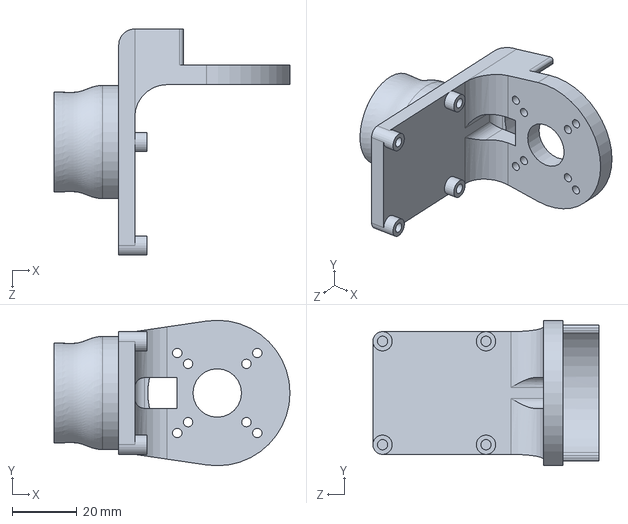
[picture p31: CAD file, 2026-08-27]
CAD/6-DOF Arm/Actuators+Linkages/j4j5_assem/j5_connector_2.SLDPRT
73.0 x 45.0 x 70.0 mm
