ericjhoh/6-DOF-Arm/CAD/6-DOF Arm/tube_connector.SLDPRT

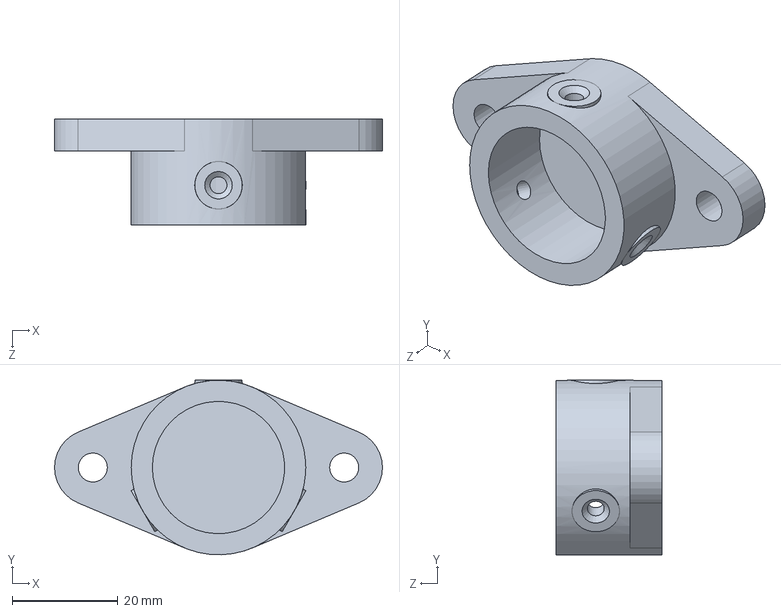
[picture p32: CAD file, 2026-08-08]
CAD/6-DOF Arm/tube_connector.SLDPRT
62.0 x 33.0 x 20.0 mm
