ericjhoh/6-DOF-Arm/CAD/GearBoxes/15-1 Cycloidal Gearbox/Gearbox/15-camshaft_part.SLDPRT

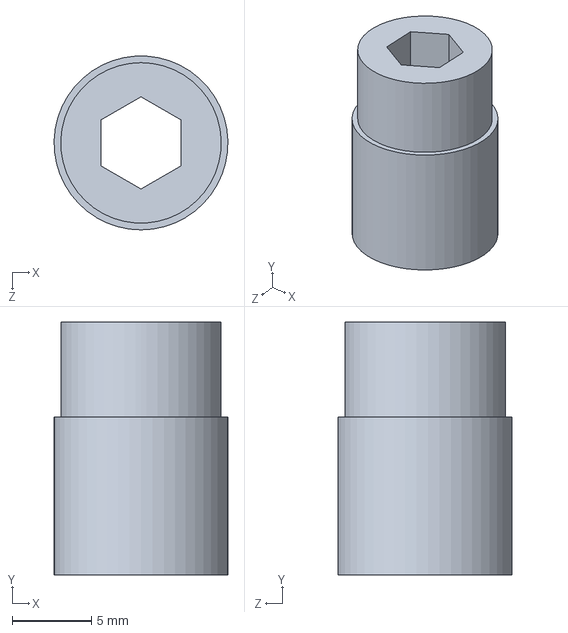
[picture p33: CAD file, 2026-08-28]
CAD/GearBoxes/15-1 Cycloidal Gearbox/Gearbox/15-camshaft_part.SLDPRT
11.0 x 16.0 x 11.0 mm
