ericjhoh/6-DOF-Arm/CAD/GearBoxes/15-1 Cycloidal Gearbox/Gearbox/Attachments/15_attachement2.SLDPRT

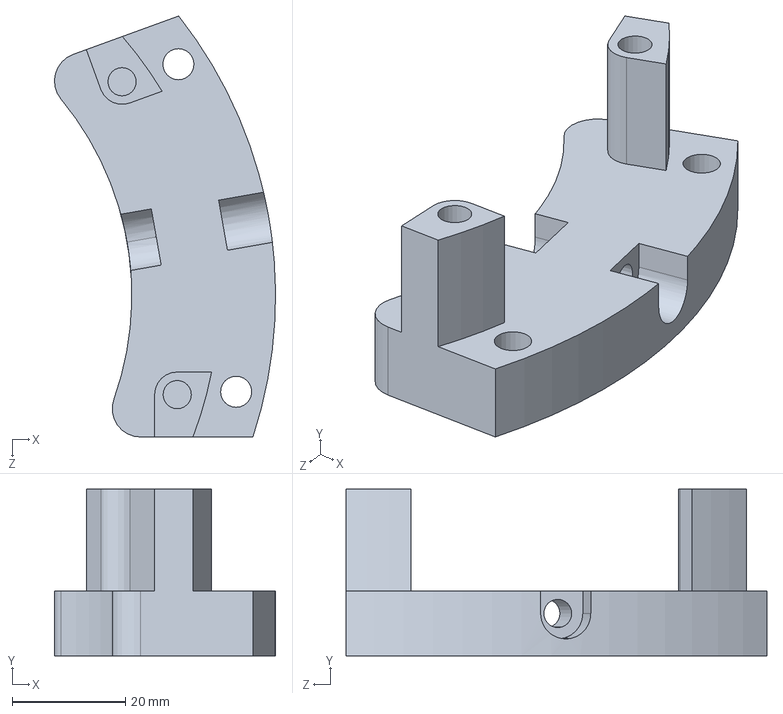
[picture p34: CAD file, 2026-08-11]
CAD/GearBoxes/15-1 Cycloidal Gearbox/Gearbox/Attachments/15_attachement2.SLDPRT
39.1 x 29.5 x 74.5 mm
