ericjhoh/6-DOF-Arm/CAD/GearBoxes/15-1 Cycloidal Gearbox/Gearbox/Stls/15-camshaft_part_centered.STL

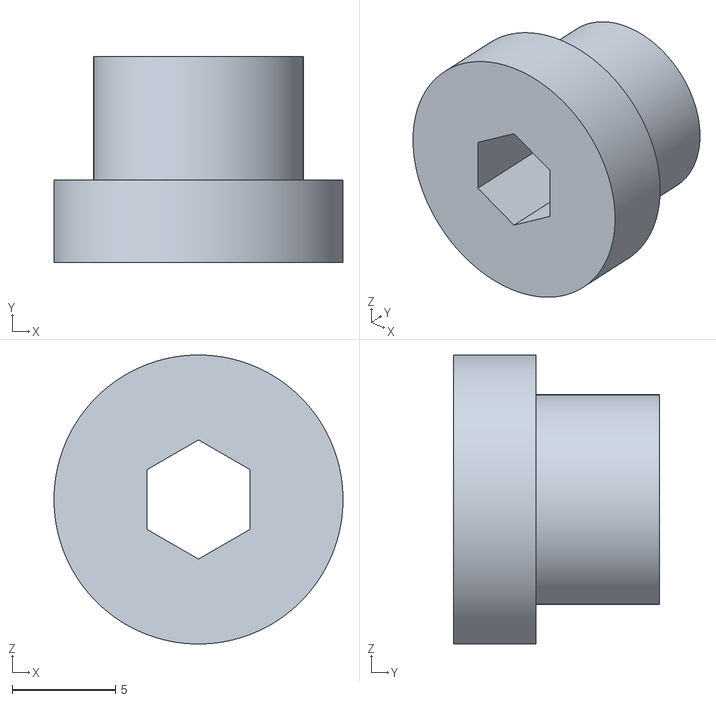
[picture p35: CAD file, 2026-08-26]
CAD/GearBoxes/15-1 Cycloidal Gearbox/Gearbox/Stls/15-camshaft_part_centered.STL
14.0 x 10.0 x 14.0
