ericjhoh/6-DOF-Arm/CAD/GearBoxes/30-1 Cycloidal Gearbox/Gearbox/Testing/30-stand.SLDPRT

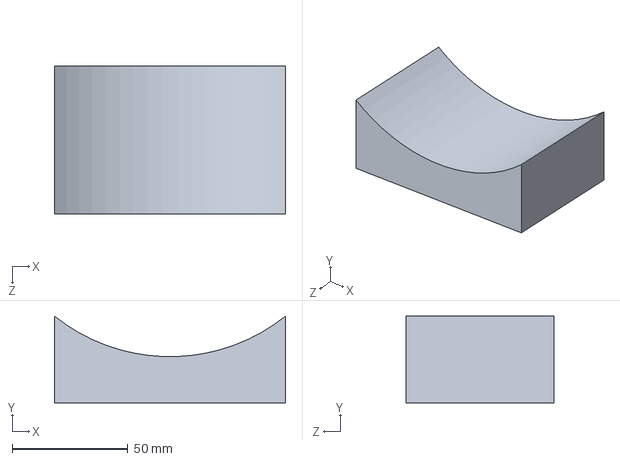
[picture p36: CAD file, 2026-08-03]
CAD/GearBoxes/30-1 Cycloidal Gearbox/Gearbox/Testing/30-stand.SLDPRT
100.0 x 37.6 x 64.0 mm
