ericjhoh/6-DOF-Arm/CAD/GearBoxes/Motor Housing/8_1 gearbox housings/moteus-bracket.SLDPRT

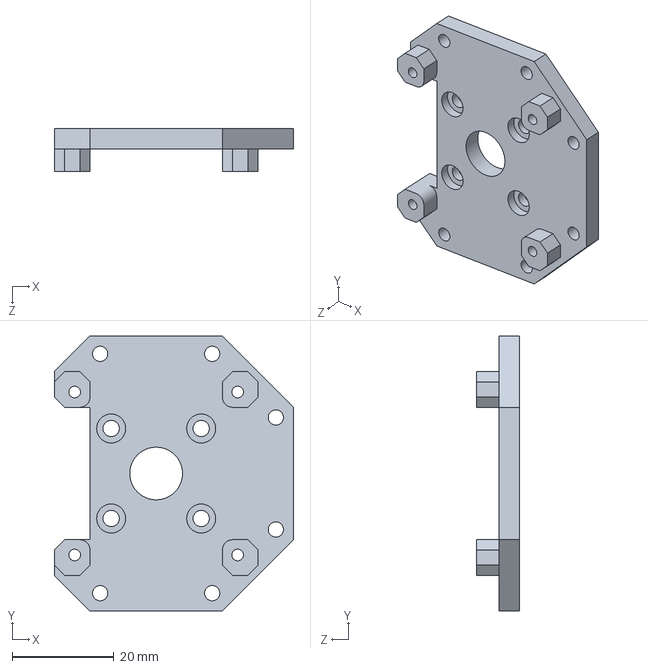
[picture p37: CAD file, 2026-08-11]
CAD/GearBoxes/Motor Housing/8_1 gearbox housings/moteus-bracket.SLDPRT
47.0 x 54.0 x 8.42 mm
