ericjhoh/6-DOF-Arm/CAD/GearBoxes/Motor Housing/raw_motor_lever.STL

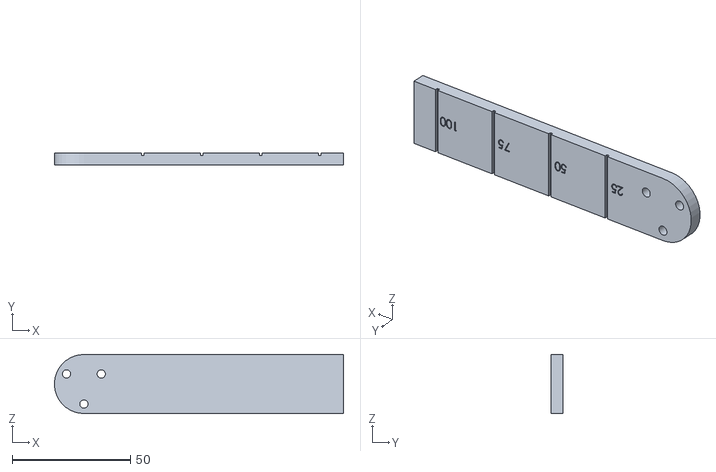
[picture p38: CAD file, 2026-08-10]
CAD/GearBoxes/Motor Housing/raw_motor_lever.STL
122.5 x 5.00 x 25.0
