ericjhoh/6-DOF-Arm/CAD/6-DOF Arm/Actuators+Linkages/j4j5_assem/j5_connector_1.SLDPRT

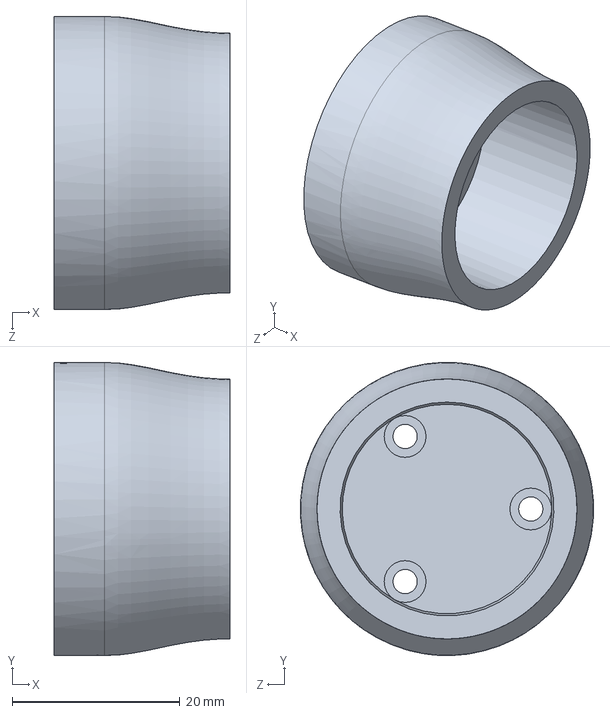
[picture p39: CAD file, 2026-08-27]
CAD/6-DOF Arm/Actuators+Linkages/j4j5_assem/j5_connector_1.SLDPRT
21.0 x 35.0 x 35.0 mm
