ericjhoh/6-DOF-Arm/CAD/GearBoxes/15-1 Cycloidal Gearbox/Gearbox/15-output_flange.SLDPRT

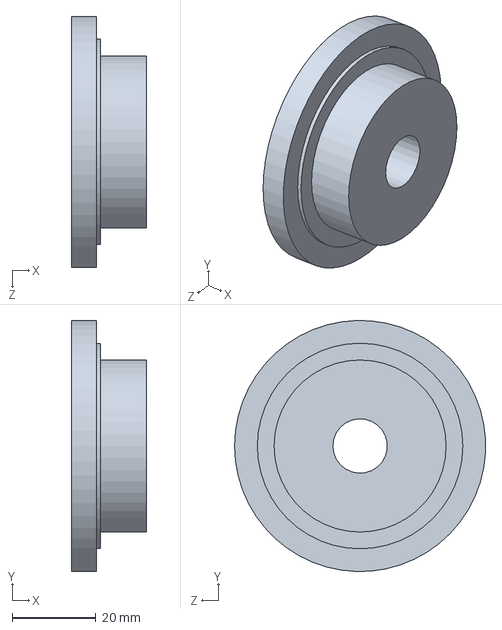
[picture p40: CAD file, 2026-08-28]
CAD/GearBoxes/15-1 Cycloidal Gearbox/Gearbox/15-output_flange.SLDPRT
18.0 x 60.0 x 59.9 mm
