ericjhoh/6-DOF-Arm/CAD/GearBoxes/15-1 Cycloidal Gearbox/Gearbox/Attachments/15-J1-output.SLDPRT

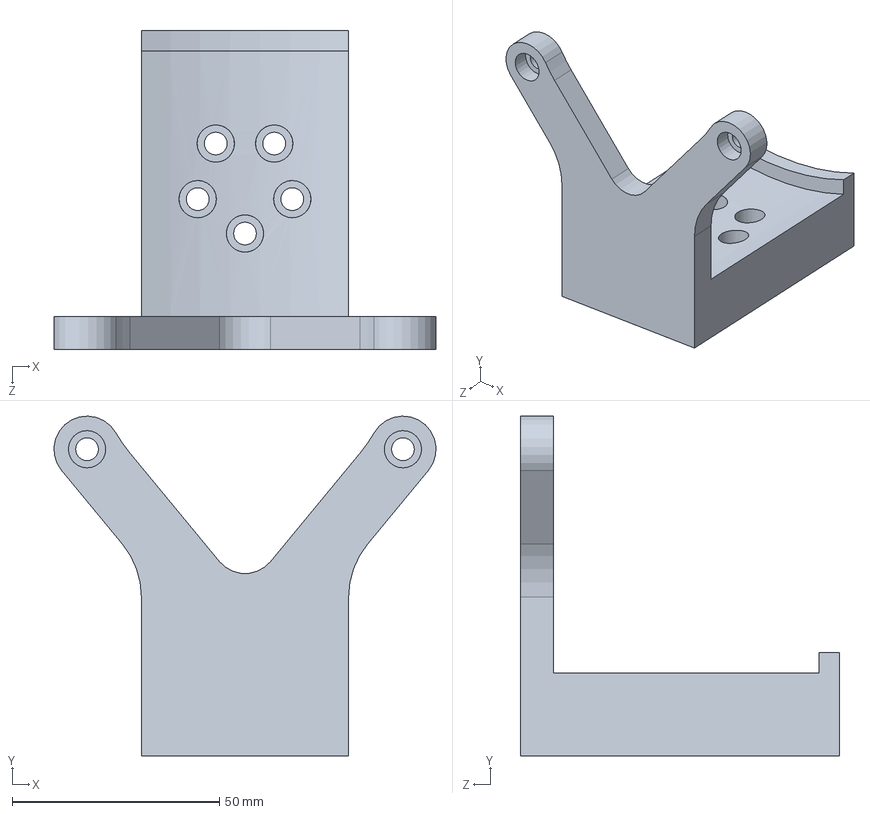
[picture p41: CAD file, 2026-08-08]
CAD/GearBoxes/15-1 Cycloidal Gearbox/Gearbox/Attachments/15-J1-output.SLDPRT
92.2 x 82.0 x 77.0 mm
