ericjhoh/6-DOF-Arm/CAD/GearBoxes/Motor Housing/coupler.SLDPRT

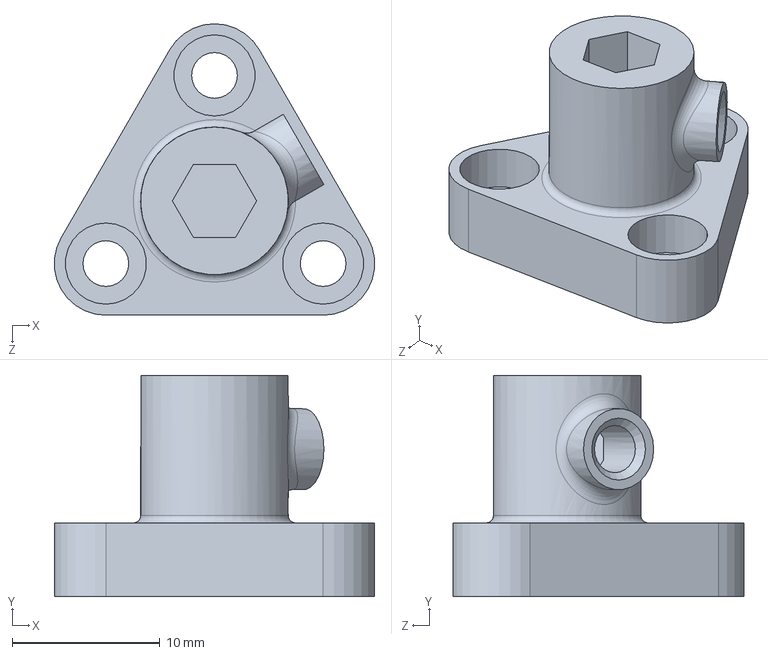
[picture p42: CAD file, 2026-08-07]
CAD/GearBoxes/Motor Housing/coupler.SLDPRT
21.7 x 15.0 x 19.8 mm
