ericjhoh/6-DOF-Arm/CAD/GearBoxes/Shared_Parts/bearings.SLDPRT

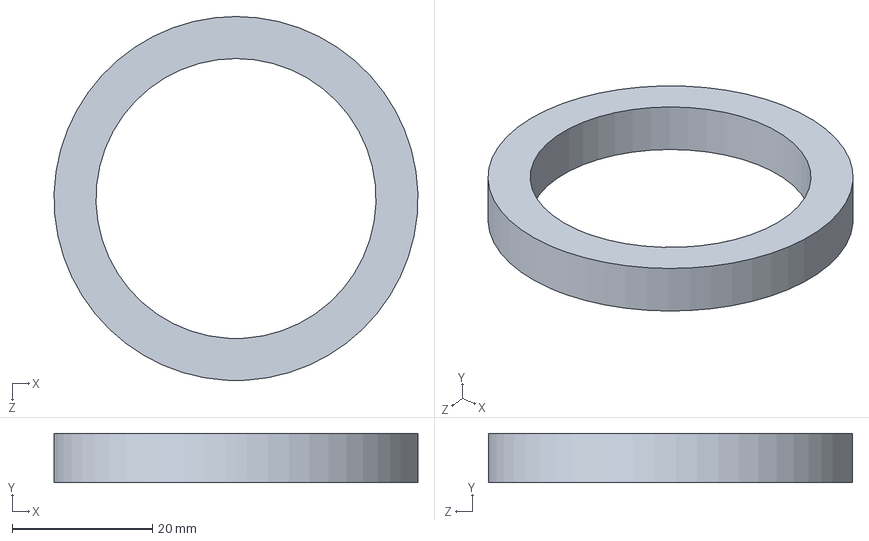
[picture p43: CAD file, 2026-07-29]
CAD/GearBoxes/Shared_Parts/bearings.SLDPRT
52.0 x 7.00 x 52.0 mm
