ericjhoh/6-DOF-Arm/CAD/6-DOF Arm/Actuators+Linkages/j4j5_assem/j4_connector.SLDPRT

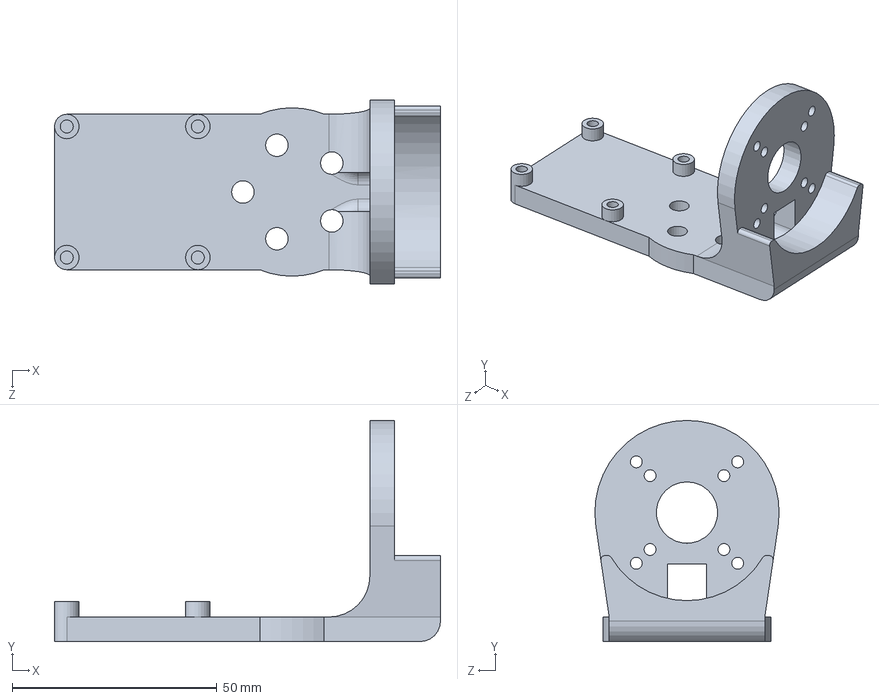
[picture p44: CAD file, 2026-08-27]
CAD/6-DOF Arm/Actuators+Linkages/j4j5_assem/j4_connector.SLDPRT
94.2 x 54.0 x 45.0 mm
