ericjhoh/6-DOF-Arm/CAD/GearBoxes/Motor Housing/MC_DKB_11_20200417.SLDPRT

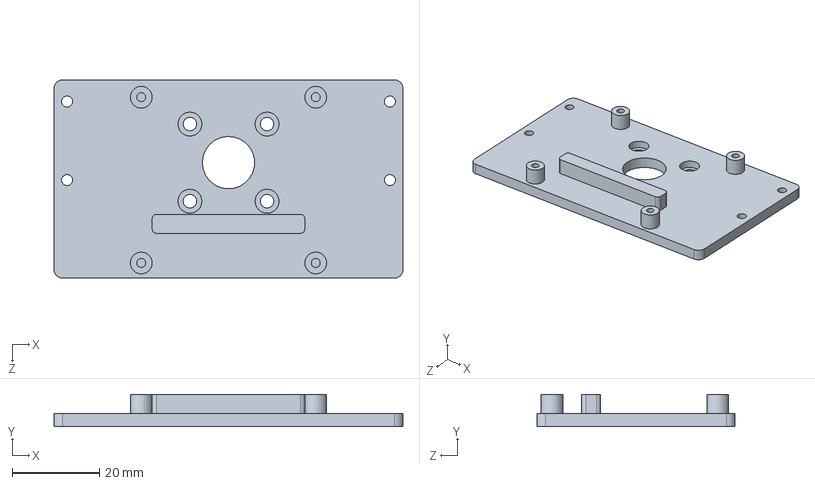
[picture p46: CAD file, 2026-07-24]
CAD/GearBoxes/Motor Housing/MC_DKB_11_20200417.SLDPRT
80.0 x 7.40 x 45.5 mm
