ericjhoh/6-DOF-Arm/CAD/GearBoxes/Shared_Parts/ring_pin.SLDPRT

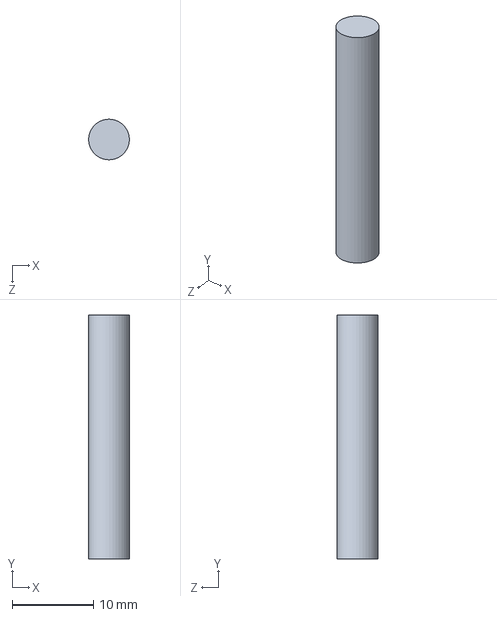
[picture p47: CAD file, 2026-07-24]
CAD/GearBoxes/Shared_Parts/ring_pin.SLDPRT
4.98 x 30.0 x 5.00 mm
