ericjhoh/6-DOF-Arm/CAD/6-DOF Arm/Actuators+Linkages/j4j5_assem/moteus_c1.SLDPRT

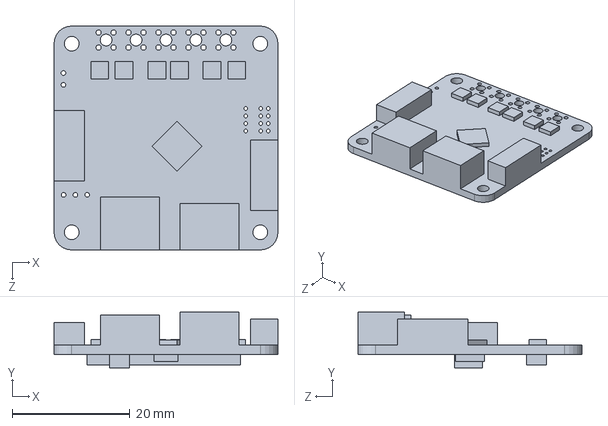
[picture p48: CAD file, 2026-08-27]
CAD/6-DOF Arm/Actuators+Linkages/j4j5_assem/moteus_c1.SLDPRT
38.0 x 9.50 x 38.0 mm
