ericjhoh/6-DOF-Arm/CAD/GearBoxes/15-1 Cycloidal Gearbox/Gearbox/Stls/15-input_wall.STL

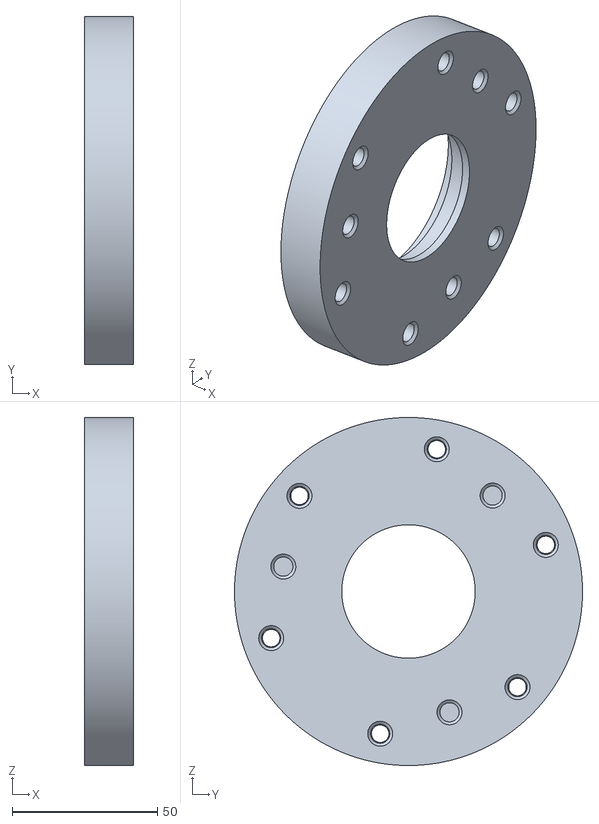
[picture p49: CAD file, 2026-08-26]
CAD/GearBoxes/15-1 Cycloidal Gearbox/Gearbox/Stls/15-input_wall.STL
17.0 x 120.0 x 120.0
