ericjhoh/6-DOF-Arm/CAD/GearBoxes/30-1 Cycloidal Gearbox/Gearbox/30-output_wall.SLDPRT

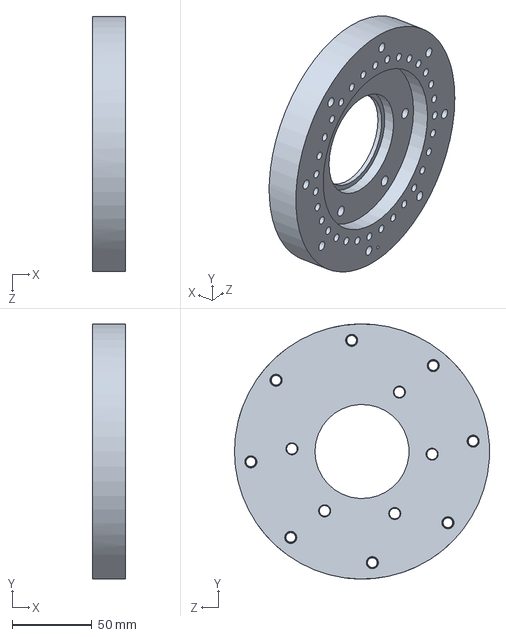
[picture p50: CAD file, 2026-08-26]
CAD/GearBoxes/30-1 Cycloidal Gearbox/Gearbox/30-output_wall.SLDPRT
21.0 x 159.9 x 160.0 mm
