ericjhoh/6-DOF-Arm/CAD/GearBoxes/Shared_Parts/hex_shaft.SLDPRT

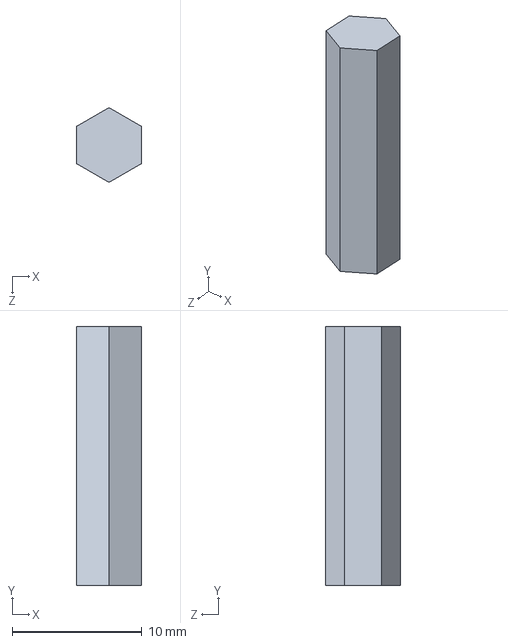
[picture p51: CAD file, 2026-07-24]
CAD/GearBoxes/Shared_Parts/hex_shaft.SLDPRT
5.00 x 20.0 x 5.77 mm
