ericjhoh/6-DOF-Arm/CAD/GearBoxes/15-1 Cycloidal Gearbox/Gearbox/15-middle_wall_print.SLDPRT

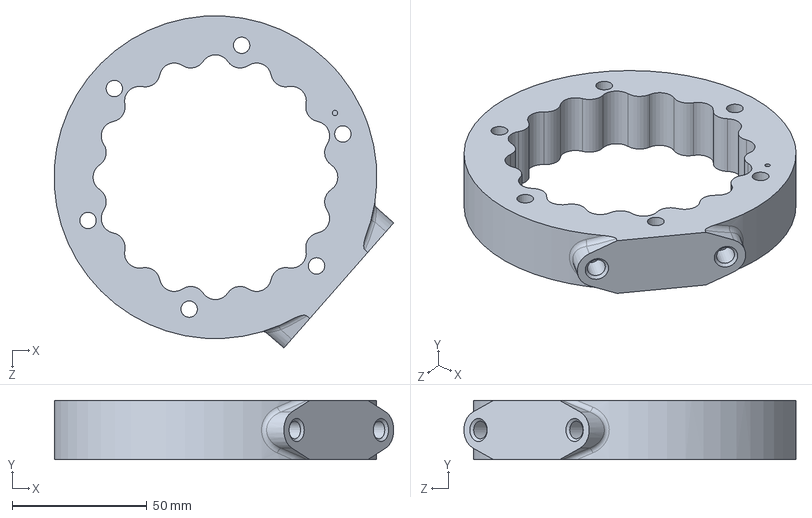
[picture p52: CAD file, 2026-08-27]
CAD/GearBoxes/15-1 Cycloidal Gearbox/Gearbox/15-middle_wall_print.SLDPRT
126.2 x 22.0 x 123.4 mm
