ericjhoh/6-DOF-Arm/CAD/GearBoxes/15-1 Cycloidal Gearbox/Gearbox/Stls/15-4mm_spacers.STL

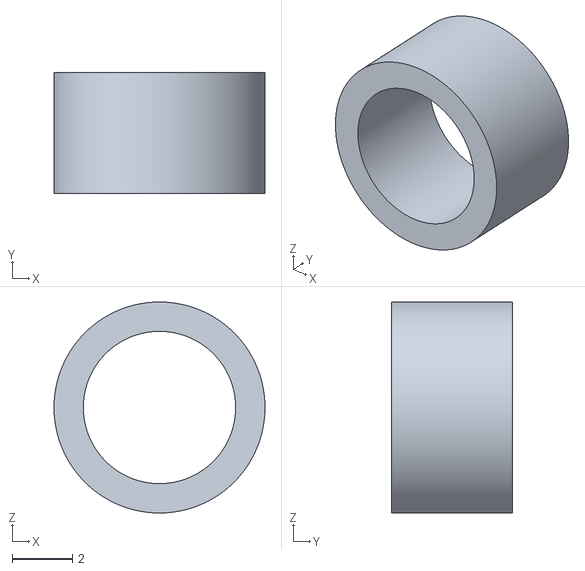
[picture p53: CAD file, 2026-08-26]
CAD/GearBoxes/15-1 Cycloidal Gearbox/Gearbox/Stls/15-4mm_spacers.STL
7.00 x 4.00 x 7.00
