ericjhoh/6-DOF-Arm/CAD/GearBoxes/30-1 Cycloidal Gearbox/Gearbox/30-output_flange.SLDPRT

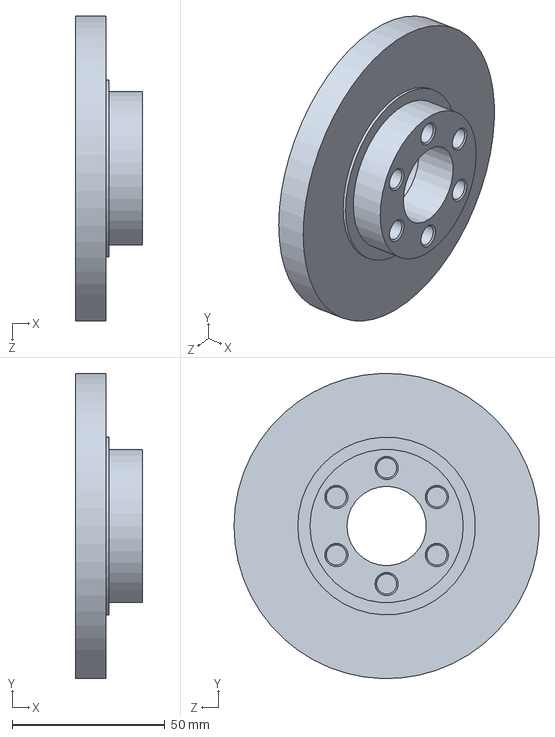
[picture p54: CAD file, 2026-08-08]
CAD/GearBoxes/30-1 Cycloidal Gearbox/Gearbox/30-output_flange.SLDPRT
22.0 x 100.0 x 99.9 mm
