ericjhoh/6-DOF-Arm/CAD/GearBoxes/15-1 Cycloidal Gearbox/Gearbox/15-cycloidal_disk_ethan_printing.SLDPRT

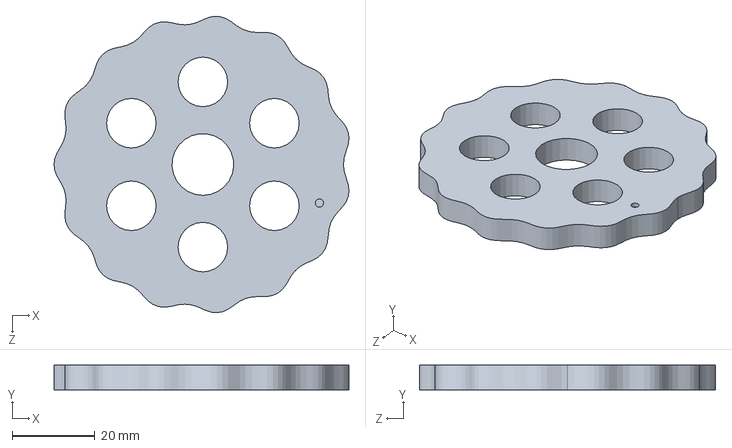
[picture p55: CAD file, 2026-08-27]
CAD/GearBoxes/15-1 Cycloidal Gearbox/Gearbox/15-cycloidal_disk_ethan_printing.SLDPRT
71.4 x 6.00 x 71.8 mm
