ericjhoh/6-DOF-Arm/CAD/GearBoxes/30-1 Cycloidal Gearbox/Gearbox/30-camshaft_part.SLDPRT

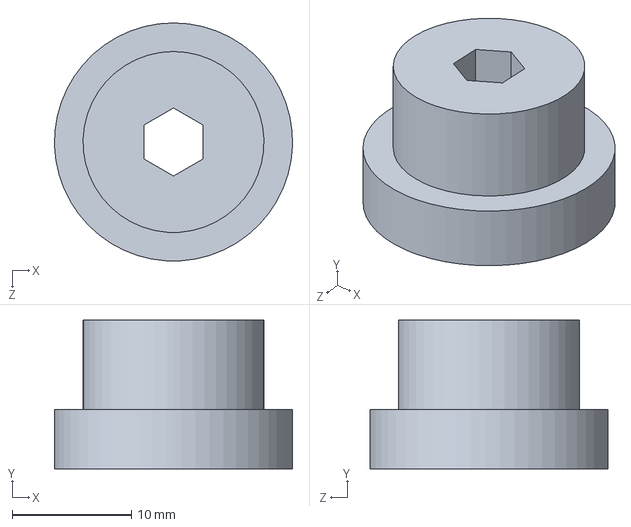
[picture p56: CAD file, 2026-08-08]
CAD/GearBoxes/30-1 Cycloidal Gearbox/Gearbox/30-camshaft_part.SLDPRT
20.0 x 12.5 x 20.0 mm
