ericjhoh/6-DOF-Arm/CAD/GearBoxes/30-1 Cycloidal Gearbox/Gearbox/30-middle_wall.SLDPRT

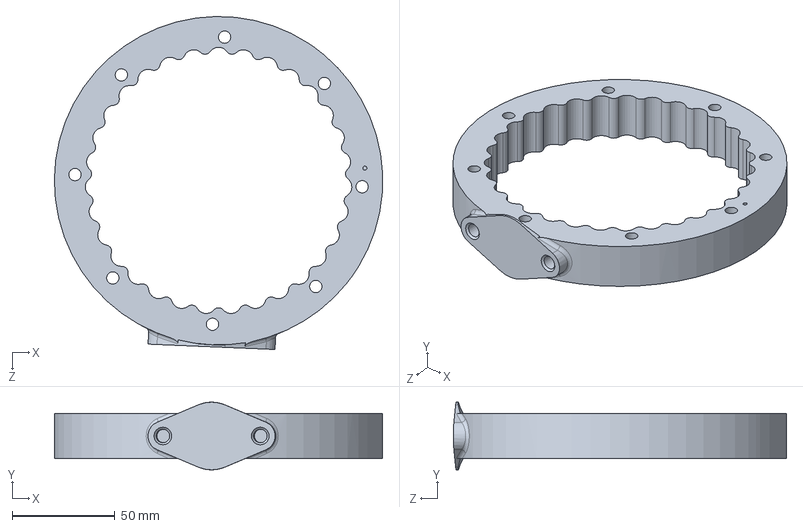
[picture p57: CAD file, 2026-08-07]
CAD/GearBoxes/30-1 Cycloidal Gearbox/Gearbox/30-middle_wall.SLDPRT
159.9 x 33.0 x 162.2 mm
