ericjhoh/6-DOF-Arm/CAD/GearBoxes/30-1 Cycloidal Gearbox/Gearbox/Stls/30-motor_housing.STL

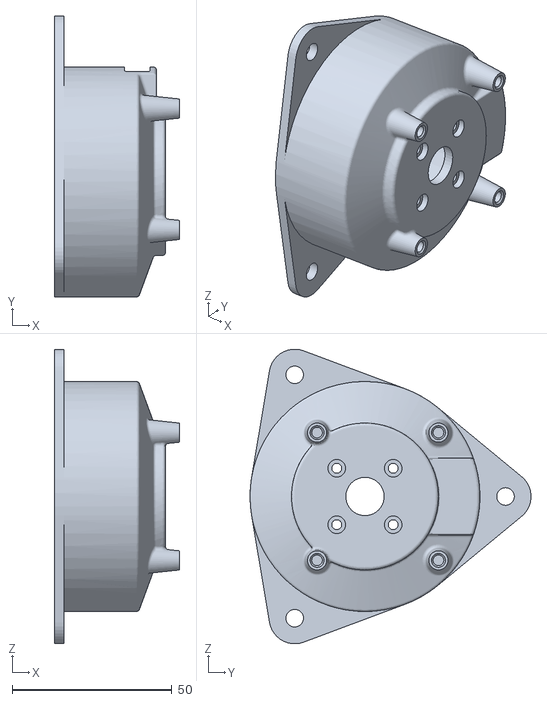
[picture p58: CAD file, 2026-07-31]
CAD/GearBoxes/30-1 Cycloidal Gearbox/Gearbox/Stls/30-motor_housing.STL
39.2 x 88.0 x 92.2
