ericjhoh/6-DOF-Arm/CAD/GearBoxes/30-1 Cycloidal Gearbox/Gearbox/Stls/30-camshaft_part_eccentric.STL

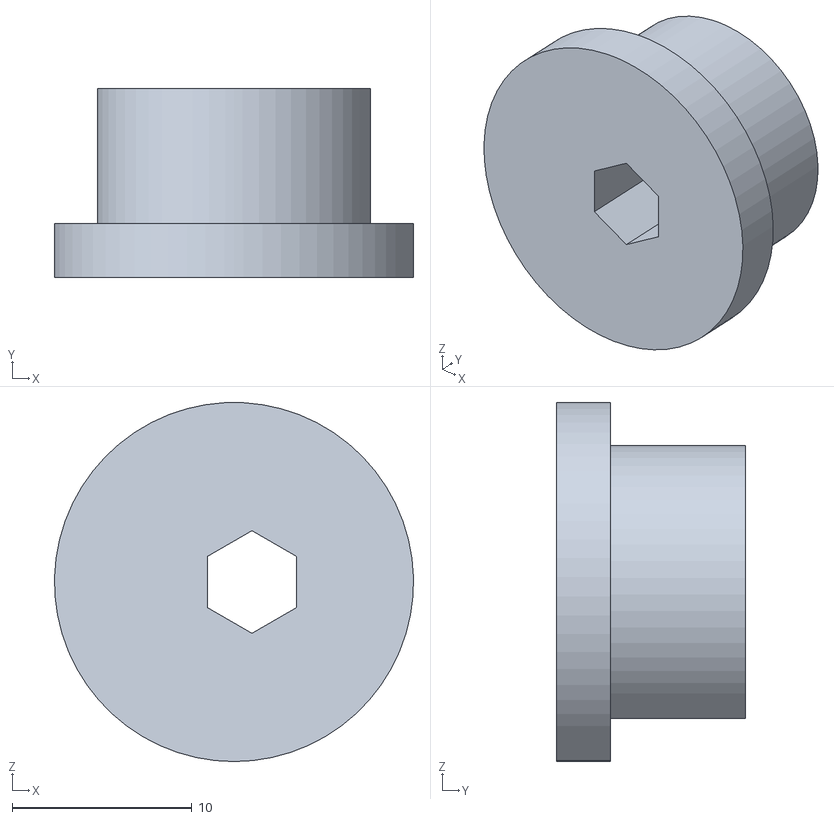
[picture p59: CAD file, 2026-07-30]
CAD/GearBoxes/30-1 Cycloidal Gearbox/Gearbox/Stls/30-camshaft_part_eccentric.STL
20.0 x 10.5 x 20.0
