ericjhoh/6-DOF-Arm/CAD/GearBoxes/30-1 Cycloidal Gearbox/Gearbox/Stls/30-camshaft_part_centered.STL

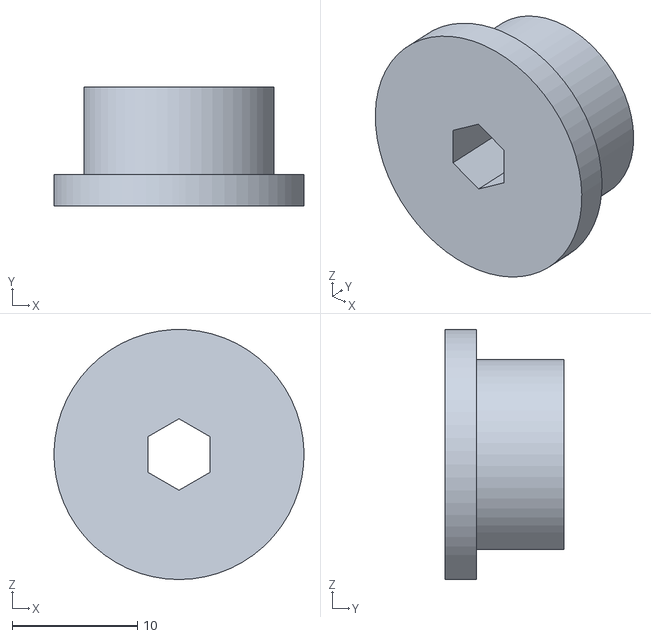
[picture p60: CAD file, 2026-07-30]
CAD/GearBoxes/30-1 Cycloidal Gearbox/Gearbox/Stls/30-camshaft_part_centered.STL
20.0 x 9.50 x 20.0
