ericjhoh/6-DOF-Arm/CAD/GearBoxes/15-1 Cycloidal Gearbox/Gearbox/15-cycloidal_disk_ethan_print.SLDPRT

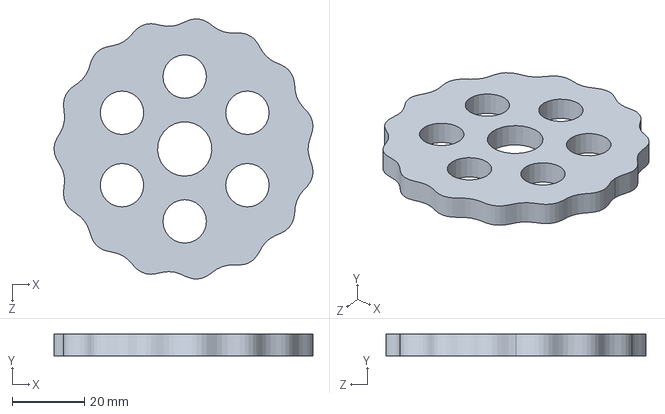
[picture p61: CAD file, 2026-08-26]
CAD/GearBoxes/15-1 Cycloidal Gearbox/Gearbox/15-cycloidal_disk_ethan_print.SLDPRT
71.5 x 6.00 x 71.9 mm
