ericjhoh/6-DOF-Arm/(list of files, cad)

Other CAD files:
CAD/GearBoxes/30-1 Cycloidal Gearbox/Gearbox/Stls/30-cycloidal_disk-printing_final.STL
CAD/GearBoxes/test printing/4.95hex_3.45insert_5.05pin.STL
CAD/GearBoxes/30-1 Cycloidal Gearbox/Gearbox/Stls/30-cycloidal_disk-printing+.1.STL
CAD/GearBoxes/test printing/testing tolerances_4.9hex_5.1dowel_3.3_insert.STL
CAD/GearBoxes/15-1 Cycloidal Gearbox/Gearbox/Stls/15-3mm_camshaft_spacers.STL
CAD/GearBoxes/30-1 Cycloidal Gearbox/Gearbox/30-cycloidal_disk.SLDPRT
CAD/GearBoxes/30-1 Cycloidal Gearbox/Gearbox/Stls/30-lever.3mf
CAD/GearBoxes/30-1 Cycloidal Gearbox/Gearbox/30-cycloidal_disk-printing.SLDPRT
CAD/GearBoxes/30-1 Cycloidal Gearbox/Gearbox/Stls/30-stand.STL
CAD/GearBoxes/Motor Housing/8_1 gearbox housings/housing-test.SLDPRT
CAD/GearBoxes/30-1 Cycloidal Gearbox/Gearbox/Stls/30-press.STL
CAD/6-DOF Arm/Actuators+Linkages/j4j5_assem/15-output_flange.SLDPRT
CAD/GearBoxes/15-1 Cycloidal Gearbox/Gearbox/Stls/15-camshaft_part_input.STL
CAD/GearBoxes/30-1 Cycloidal Gearbox/Gearbox/Stls/30-4mm_spacers.3mf
CAD/GearBoxes/30-1 Cycloidal Gearbox/Gearbox/Stls/30-coupler.3mf
CAD/GearBoxes/15-1 Cycloidal Gearbox/Gearbox/Stls/15-camshaft_part_eccentric.STL
CAD/GearBoxes/30-1 Cycloidal Gearbox/Gearbox/Stls/30-input_wall.STL
CAD/GearBoxes/15-1 Cycloidal Gearbox/Gearbox/15-middle_wall.SLDPRT
CAD/GearBoxes/15-1 Cycloidal Gearbox/Gearbox/15-output_wall.SLDPRT
CAD/GearBoxes/30-1 Cycloidal Gearbox/Gearbox/Stls/30-6mm_spacers.STL
CAD/GearBoxes/15-1 Cycloidal Gearbox/Gearbox/15-cycloidal_disk_ethan2_printing.SLDPRT
CAD/GearBoxes/15-1 Cycloidal Gearbox/Gearbox/15-cycloidal_disk_ethan2.SLDPRT
CAD/GearBoxes/30-1 Cycloidal Gearbox/Gearbox/Stls/30-camshaft_part_input.STL
CAD/GearBoxes/15-1 Cycloidal Gearbox/Gearbox/15-cycloidal_disk_ethan2_print.SLDPRT
CAD/GearBoxes/15-1 Cycloidal Gearbox/Gearbox/15-cycloidal_disk_ethan.SLDPRT
CAD/6-DOF Arm/carbon_fiber_tube.SLDPRT
CAD/6-DOF Arm/j4_connector.SLDPRT
CAD/GearBoxes/15-1 Cycloidal Gearbox/Gearbox/Stls/15-cycloidal_disk_ethan2_printing.STL
CAD/GearBoxes/15-1 Cycloidal Gearbox/Gearbox/Stls/15-cycloidal_disk_ethan_printing.STL
CAD/GearBoxes/15-1 Cycloidal Gearbox/Gearbox/Stls/15-middle_wall.STL
CAD/GearBoxes/15-1 Cycloidal Gearbox/Gearbox/Stls/15-output_flange.STL
CAD/GearBoxes/15-1 Cycloidal Gearbox/Gearbox/Stls/15-output_wall.STL
CAD/GearBoxes/30-1 Cycloidal Gearbox/Gearbox/Stls/30-4mm_spacers.STL
CAD/GearBoxes/30-1 Cycloidal Gearbox/Gearbox/Stls/30-coupler.STL
CAD/GearBoxes/30-1 Cycloidal Gearbox/Gearbox/Stls/30-cycloidal_disk-printing.STL
CAD/GearBoxes/30-1 Cycloidal Gearbox/Gearbox/Stls/30-cycloidal_disk.STL
CAD/GearBoxes/30-1 Cycloidal Gearbox/Gearbox/Stls/30-lever.STL
CAD/GearBoxes/30-1 Cycloidal Gearbox/Gearbox/Stls/30-middle_wall.STL
CAD/GearBoxes/30-1 Cycloidal Gearbox/Gearbox/Stls/30-output_flange.STL
CAD/GearBoxes/30-1 Cycloidal Gearbox/Gearbox/Stls/30-output_wall.3mf
CAD/GearBoxes/30-1 Cycloidal Gearbox/Gearbox/Stls/30-output_wall.STL
CAD/GearBoxes/Motor Housing/20210124-moteus-controller-r45-mechanical.SLDPRT
CAD/GearBoxes/Motor Housing/8_1 gearbox housings/20240305-moteus-c1-r1_2.SLDPRT
CAD/GearBoxes/Shared_Parts/shoulder_bolt.SLDPRT
CAD/GearBoxes/test printing/testing tolerances.STL
