ericjhoh/6-DOF-Arm/CAD/GearBoxes/30-1 Cycloidal Gearbox/Gearbox/30_1 Gearbox Parameters.txt

30:1 Gearbox Parameters:

Outer Ring Diameter: 120 mm
Radius of Rollers: 5 mm (10 mm Diameter)
Number of Roller: 31
Eccentricity: 1 mm
Diameter of Camshaft: 20 mm
Diameter of Output: 80 mm
Number of Output Rollers: 8
Radius of Output Rollers: 5 mm (10 mm Diameter)
Thickness of Disk: 8 mm

2 Cycloidal Disks 180 Degrees apart


X = (R*cos(t))-(Rr*cos(t+arctan(sin((1-N)*t)/((R/EN)-cos((1-N)*t)))))-(E*cos(N*t))
Y = (-R*sin(t))+(Rr*sin(t+arctan(sin((1-N)*t)/((R/EN)-cos((1-N)*t)))))+(E*sin(N*t))

X = (60*cos(t))-(5*cos(t+arctan(sin((1-31)*t)/((60/(1*31))-cos((1-31)*t)))))-(1*cos(31*t))
Y = (-60*sin(t))+(5*sin(t+arctan(sin((1-31)*t)/((60/(1*31))-cos((1-31)*t)))))+(1*sin(31*t))

 
output bearings: OD 10 mm 5x10x4
roller bearings: OD 10 mm 5x10x4
https://www.amazon.com/MR105-2RS-Deep-Groove-Ball-Bearings/dp/B0DY184NF4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


camshaft bearings: OD 24 mm 15x28x8 
https://www.amazon.com/DUKUTS-15268-2RS-Mountain-15267C-2RS-15x26x7mm/dp/B0D93YVVJT?th=1

input/output bearings: OD 65mm 50x65x7
https://www.amazon.com/uxcell-6810-2RS-Groove-Bearings-Double/dp/B082PXZLJT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


dowel pins: 5mm x 30mmhttps://www.amazon.com/Juvielich-Stainless-Cylindrical-Bookshelf-Furniture/dp/B0DKBMBQ9K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


shoulder bolts: 64mm length M5x0.8
https://www.amazon.com/MECCANIXITY-Stainless-Hydraulic-Injection-Industries/dp/B0FDQWSQZJ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

heated inserts: https://www.amazon.com/FFVRVSS-Threaded-Assortment-Printing-Components/dp/B0H1V72B3B?th=1
