ericjhoh/6-DOF-Arm/CAD/GearBoxes/15-1 Cycloidal Gearbox/Gearbox/15_1 Gearbox Parameters.txt

15:1 Gearbox Parameters:

Outer Ring Diameter: 80 mm
Radius of Rollers: 5 mm (10 mm Diameter)
Number of Roller: 16
Eccentricity: 1 mm
Diameter of Camshaft: 15 mm
Diameter of Output: 35 mm
Number of Output Rollers: 6
Radius of Output Rollers: 5 mm (10 mm Diameter)
Thickness of Disk: 8 mm

2 Cycloidal Disks 180 Degrees apart


X = (R*cos(t))-(Rr*cos(t+arctan(sin((1-N)*t)/((R/EN)-cos((1-N)*t)))))-(E*cos(N*t))
Y = (-R*sin(t))+(Rr*sin(t+arctan(sin((1-N)*t)/((R/EN)-cos((1-N)*t)))))+(E*sin(N*t))

X = (35*cos(t))-(5*cos(t+arctan(sin((1-16)*t)/((35/(1*16))-cos((1-16)*t)))))-(1*cos(16*t))
    (35*cos(t))-(5*cos(t+arctan(sin((1-16)*t)/((35/(1*16))-cos((1-16)*t)))))-(1*cos(16*t))

Y = (-35*sin(t))+(5*sin(t+arctan(sin((1-16)*t)/((35/(1*16))-cos((1-16)*t)))))+(1*sin(16*t))
    (-35*sin(t))+(5*sin(t+arctan(sin((1-16)*t)/((35/(1*16))-cos((1-16)*t)))))+(1*sin(16*t))


Camshaft bearings: 10mm x 15mm x 4mm
https://www.amazon.com/uxcell-6700ZZ-Groove-Bearings-Shielded/dp/B082PPYZQX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
