ericjhoh/6-DOF-Arm/(commit log)

2026-07-11 updated sheet
    [arm_torque_budget_and_timeline.xlsx]
2026-07-14 BOM change
    changed some formatting
    [arm_torque_budget_and_timeline.xlsx]
2026-07-15 CAD Files
    [20210124-moteus-controller-r45-mechanical.SLDPRT, 20210124-moteus-controller-r45-mechanical.step, 301 Gearbox Parameters.txt, BOTTOM_WALL.SLDPRT, Bearing.SLDPRT, Bottom Shell.SLDPRT, CycliodalDisk1.SLDPRT, CycloidalDisk2.SLDPRT]
2026-07-24 30-1 GearBox
    Finished the gearbox iteration 1
    [20210124-moteus-controller-r45-mechanical.SLDPRT, 301 Gearbox Parameters.txt, Bottom Shell.SLDPRT, GearsAndOutput.SLDASM, MC_DKB_11_20200417.SLDPRT, MID_WALL.SLDPRT, MotorHOusingAssem.SLDASM, OutGearsandRollers.SLDASM]
2026-07-25 Some BOM for the 30-1 Cycloidal
    [6-DOF-Arm.xlsx, arm_torque_budget_and_timeline.xlsx, coupler.SLDPRT, disk+output+rollers_ASY.SLDASM, disk+output_ASY.SLDASM, main_gearbox_ASY.SLDASM]
2026-07-26 Edited for thinner camshaft bearing
    [6-DOF-Arm.xlsx, bearings.SLDPRT, camshaft.SLDASM, camshaft_part.SLDPRT, coupler.SLDPRT, disk+output+rollers_ASY.SLDASM, disk+output_ASY.SLDASM, main_gearbox_ASY.SLDASM]
2026-07-27 Finished Bom. Ordering parts soon
    [6-DOF-Arm.xlsx, disk+output+rollers_ASY.SLDASM, disk+output_ASY.SLDASM, main_gearbox_ASY.SLDASM]
2026-07-28 Start of 15:1 cycloidal gearbox
    something is wrong with my assembly of the 15:1 cycloidal gearbox. The outer roller pins don't seem to match up with the cycloidal disks causing interferences.
    [15-camshaft_ASY.SLDASM, 15-camshaft_part.SLDPRT, 15-cycloidal_disk.SLDPRT, 15-disk+output+rollers_ASY.SLDASM, 15-disk+output_ASY.SLDASM, 15_1 Gearbox Parameters.txt, 20210124-moteus-controller-r45-mechanical.SLDPRT, 20210124-moteus-controller-r45-mechanical.step]
2026-07-29 15:1 Cycloidal Gearbox Gears
    [15-camshaft_ASY.SLDASM, 15-camshaft_part.SLDPRT, 15-cycloidal_disk.SLDPRT, 15-cycloidal_disk_ethan.SLDPRT, 15-cycloidal_disk_ethan2.SLDPRT, 15-disk+output+rollers_ASY.SLDASM, 15-disk+output_ASY.SLDASM, 15-disk+output_ASY_ethan.SLDASM]
2026-07-30 Finished with 15:1 gearbox
    Next step is to start printing the parts of the gearbox.
    [15-camshaft_ASY.SLDASM, 15-camshaft_part.SLDPRT, 15-disk+output+rollers+flanges_ASY.SLDASM, 15-disk+output+rollers_ASY.SLDASM, 15-disk+output_ASY_ethan.SLDASM, 15-gearbox_ASY.SLDASM, 15-middle_wall.SLDPRT, 15-output_wall.SLDPRT]
2026-07-31 Printed 30:1 motor housing
    [20210124-moteus-controller-r45-mechanical.SLDPRT, 30-input_wall.STL, 30-motor_housing.STL, 30-output_wall.SLDPRT, 6-DOF-Arm.xlsx, motor housing.SLDPRT, motor housing.STL]
2026-07-31 Printing other parts of the 30:1 gearbox
    [30-middle_wall.STL, 30-output_wall.3mf, 30-output_wall.SLDPRT, 30-output_wall.STL, camshaft_part.3mf]
2026-08-03 Updated 15:1 gearbox and BOM
    reduced cost of 15:1 by reducing shoulder screw count, updated BOM to account for 2 15:1 gearboxes
    [15-camshaft_ASY.SLDASM, 15-disk+output+rollers+flanges_ASY.SLDASM, 15-disk+output+rollers_ASY.SLDASM, 15-disk+output_ASY_ethan.SLDASM, 15-gearbox_ASY.SLDASM, 15-middle_wall.SLDPRT, 15-output_wall.SLDPRT, 30-lever.3mf]
2026-08-04 Ordered parts for 15:1
    [15-disk+output_ASY_ethan.SLDASM, 30-disk+output+rollers_ASY.SLDASM, 30-disk+output_ASY.SLDASM, 6-DOF-Arm.xlsx, motor housing.SLDPRT]
2026-08-05 Starting 6-DOF arm assembly
    [15-disk+output_ASY_ethan.SLDASM, 30-camshaft_ASY.SLDASM, 30-disk+output+rollers_ASY.SLDASM, 30-disk+output_ASY.SLDASM, 30-gearbox_ASY.SLDASM, 30-lever.SLDPRT, 30-output_flange.SLDPRT, 4.95hex_3.45insert_5.05pin.STL]
2026-08-06 Arm Assembly
    I'm not sure how to connect the different gearboxes with each other
    [15-disk+output_ASY_ethan.SLDASM, 15-tube_attachment.SLDPRT, 30-gearbox_ASY.SLDASM, 30-tube_attachment.SLDPRT, tube_attachment.SLDPRT]
2026-08-07 testing different ways to attach linkages
    [15-camshaft_ASY.SLDASM, 15-camshaft_part.SLDPRT, 15-disk+output+rollers+flanges_ASY.SLDASM, 15-disk+output+rollers_ASY.SLDASM, 15-disk+output_ASY_ethan.SLDASM, 15-gearbox_ASY.SLDASM, 15-middle_wall.SLDPRT, 15-output_attachment.SLDPRT]
2026-08-07 J2 linkage done
    [15-tube.SLDPRT, 30-attachment.SLDPRT, 30-attachment1.SLDPRT, 30-attachment_ASY.SLDASM, 30-disk+output+rollers_ASY.SLDASM, 30-disk+output_ASY.SLDASM, 30-lever.SLDPRT, 30-press.SLDPRT]
2026-08-07 J2+J3 linkage adapters
    [15-disk+output_ASY_ethan.SLDASM, 15-gearbox_ASY.SLDASM, 15-middle_wall.SLDPRT, 15-wall_attachment.SLDPRT, 30-attachment1.SLDPRT, 30-attachment_ASY.SLDASM, 30-camshaft_ASY.SLDASM, 30-camshaft_part.SLDPRT]
2026-08-08 Linkage with J1+J2
    [15-J1-output.SLDPRT, 15-camshaft_ASY.SLDASM, 15-disk+output+rollers+flanges_ASY.SLDASM, 15-disk+output_ASY_ethan.SLDASM, 15-gearbox_ASY.SLDASM, 15-middle_wall.SLDPRT, 15-output_flange.SLDPRT, 30-attachment1.SLDPRT]
2026-08-08 finished with output of J1+J2+J3 linkages
    Next steps: make base for robot arm, test max torque of regular output
    [15-J1-output.SLDPRT, 15-attachment1.SLDPRT, 15-attachment_ASY.SLDASM, 15-camshaft_ASY.SLDASM, 15-camshaft_part.SLDPRT, 15-disk+output+rollers+flanges_ASY.SLDASM, 15-disk+output+rollers_ASY.SLDASM, 15-disk+output_ASY_ethan.SLDASM]
2026-08-08 update doc
    [6-DOF-Arm.xlsx]
2026-08-10 Testing raw motor torque output
    For some reason the motor is not calibrated correctly(?)
    [6-DOF-Arm.xlsx, raw_motor_lever.STL]
2026-08-11 Design for 8:1 gear housing
    [15-attachment1.SLDPRT, 15-attachment_ASY.SLDASM, 15-camshaft_ASY.SLDASM, 15-disk+output+rollers+flanges_ASY.SLDASM, 15-disk+output_ASY_ethan.SLDASM, 15-gearbox_ASY.SLDASM, 15_attachement2.SLDPRT, 20240305-moteus-c1-r1_2.SLDPRT]
2026-08-12 trying to design motor housing for J4,5,6
    [Gim_motor+housing_ASY.SLDASM, motor housing GIM.SLDPRT]
2026-08-14 documentation start
    [6-DOF-Arm.xlsx]
2026-08-26 printing out 15:1 assembly
    [15-3mm_camshaft_spacers.STL, 15-4mm_spacers.STL, 15-6mm_spacers.STL, 15-camshaft_ASY.SLDASM, 15-camshaft_part.SLDPRT, 15-camshaft_part_centered.STL, 15-camshaft_part_eccentric.STL, 15-camshaft_part_input.STL]
2026-08-27 j4j5 pack and go
    [15-output_flange.SLDPRT, j4_connector.SLDPRT]
2026-08-27 need to test 15:1 gearbox
    [15-camshaft_ASY.SLDASM, 15-camshaft_part.SLDPRT, 15-cycloidal_disk_ethan_printing.SLDPRT, 15-disk+output+rollers+flanges_ASY.SLDASM, 15-disk+output+rollers_ASY.SLDASM, 15-disk+output_ASY_ethan.SLDASM, 15-gearbox_ASY.SLDASM, 15-middle_wall.SLDPRT]
2026-08-27 15:1 testing
    [15-lever.SLDPRT, 15-output_flange.SLDPRT, 15-output_flange_2025.SLDPRT, 15-stand.SLDPRT, 15_lever_2026.SLDPRT]
2026-08-28 Revert "15:1 testing"
    This reverts commit 19dde5faec9054590e40c15f9ae3839370c2f371.
    [15-lever.SLDPRT, 15-output_flange.SLDPRT, 15-output_flange_2025.SLDPRT, 15-stand.SLDPRT, 15_lever_2026.SLDPRT]
2026-08-28 changed to 2025 vers
    [15-output_flange.SLDPRT]
2026-08-28 5-dof-ARM cad almost done
    [15-camshaft_ASY.SLDASM, 15-camshaft_part.SLDPRT, 15-disk+output+rollers+flanges_ASY.SLDASM, 15-disk+output+rollers_ASY.SLDASM, 15-disk+output_ASY_ethan.SLDASM, 15-gearbox_ASY.SLDASM, 15-lever.STL, 15-output_flange.SLDPRT]
